teletype7/IRIS-v2/pcb/IRISV2_TOP/IRISV2_TOP.kicad_pcb

## KiCad design pcb/IRISV2_TOP/IRISV2_TOP.kicad_pcb (2026-07-20)

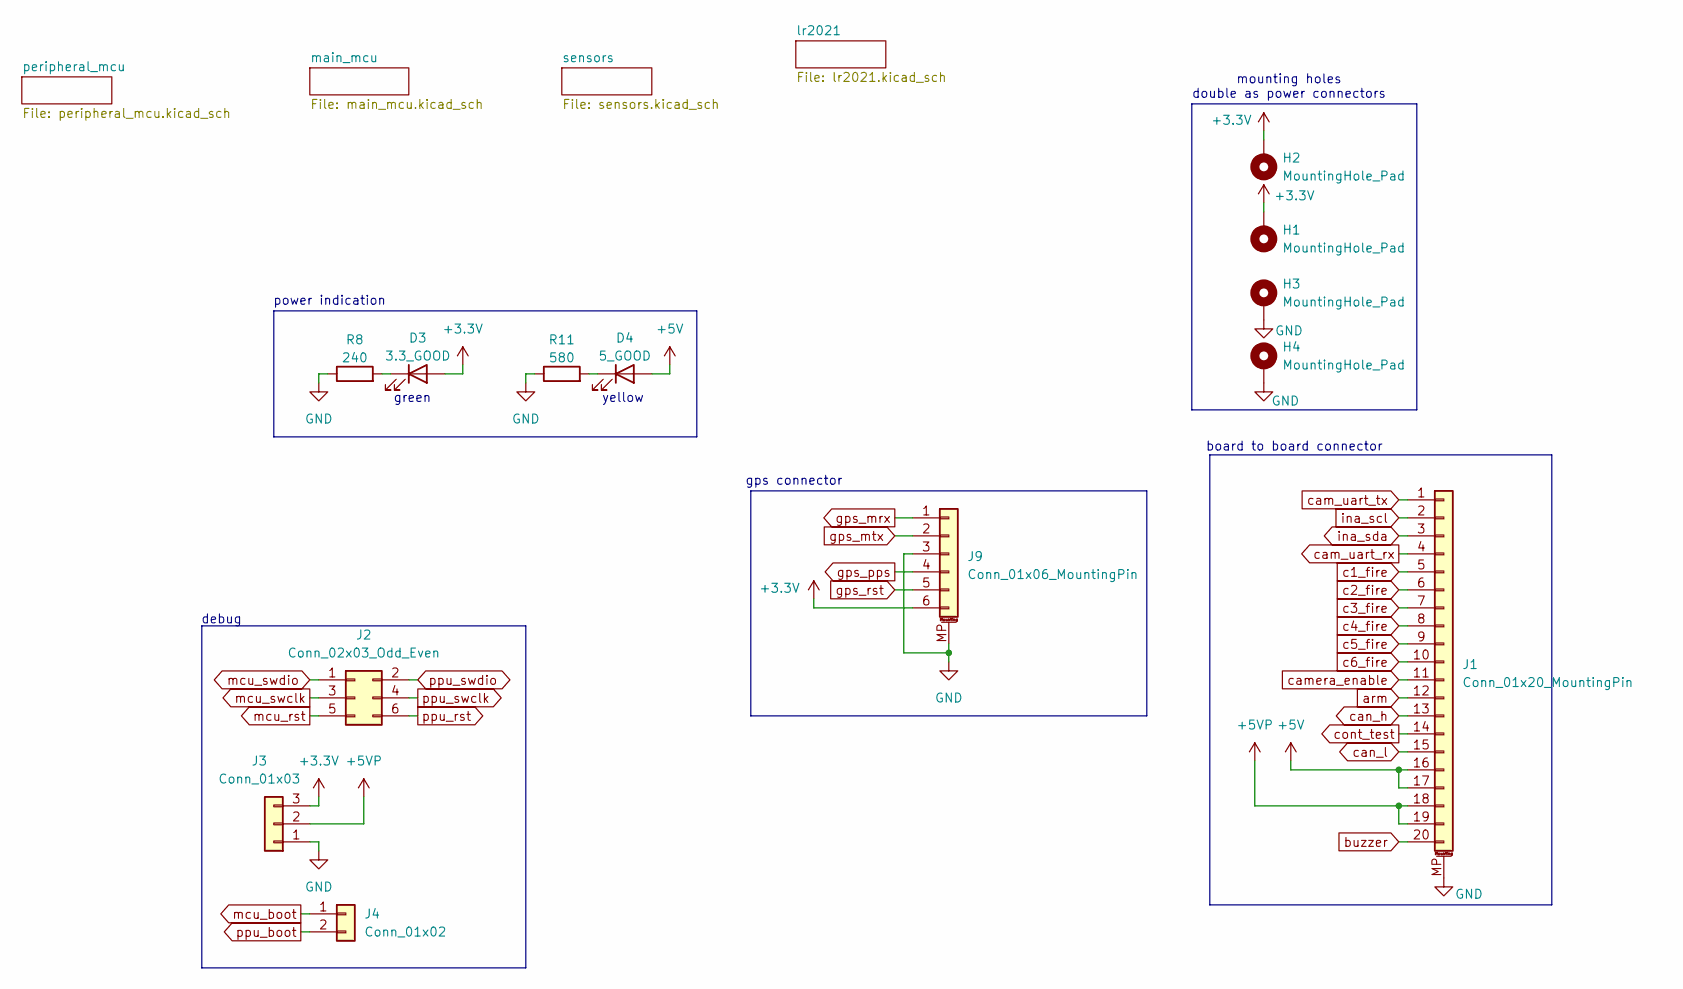
[picture p1: schematic IRISV2_TOP.kicad_sch]

Parts:
D3: 3.3_GOOD; LED_0805_2012Metric
D4: 5_GOOD; LED_0805_2012Metric
H1, H2, H3, H4: MountingHole_Pad; MountingHole_3.2mm_M3_ISO7380_Pad_TopBottom
J1: Conn_01x20_MountingPin; FFC3B07-20-T
J2: Conn_02x03_Odd_Even; PinHeader_2x03_P2.54mm_Vertical
J3: Conn_01x03; PinHeader_1x03_P2.54mm_Vertical
J4: Conn_01x02; PinHeader_1x02_P2.54mm_Vertical
J9: Conn_01x06_MountingPin; JST_PH_S6B-PH-SM4-TB_1x06-1MP_P2.00mm_Horizontal
R8: 240; R_0603_1608Metric
R11: 580; R_0603_1608Metric

Connections:
+3.3V: D3.2 (A), H1.1, H2.1, J3.3, J9.6; also elsewhere on the board
+5V: D4.2 (A), J1.16, J1.17; also elsewhere on the board
+5VP: J1.18, J1.19, J3.2
GND: H3.1, H4.1, J1.MP (MountPin), J3.1, J9.3, J9.MP (MountPin), R8.1, R11.1; also elsewhere on the board
unnamed: D3.1 (K), R8.2
unnamed: D4.1 (K), R11.2
arm: J1.12; also elsewhere on the board
buzzer: J1.20; also elsewhere on the board
c1_fire: J1.5; also elsewhere on the board
c2_fire: J1.6; also elsewhere on the board
c3_fire: J1.7; also elsewhere on the board
c4_fire: J1.8; also elsewhere on the board
c5_fire: J1.9; also elsewhere on the board
c6_fire: J1.10; also elsewhere on the board
cam_uart_rx: J1.4; also elsewhere on the board
cam_uart_tx: J1.1; also elsewhere on the board
camera_enable: J1.11; also elsewhere on the board
can_h: J1.13; also elsewhere on the board
can_l: J1.15; also elsewhere on the board
cont_test: J1.14; also elsewhere on the board
gps_mrx: J9.1; also elsewhere on the board
gps_mtx: J9.2; also elsewhere on the board
gps_pps: J9.4
gps_rst: J9.5
ina_scl: J1.2; also elsewhere on the board
ina_sda: J1.3; also elsewhere on the board
mcu_boot: J4.1; also elsewhere on the board
mcu_rst: J2.5; also elsewhere on the board
mcu_swclk: J2.3; also elsewhere on the board
mcu_swdio: J2.1; also elsewhere on the board
ppu_boot: J4.2; also elsewhere on the board
ppu_rst: J2.6; also elsewhere on the board
ppu_swclk: J2.4; also elsewhere on the board
ppu_swdio: J2.2; also elsewhere on the board

Notes on the sheet:
gps connector
debug
board to board connector
power indication
yellow
mounting holes double as power connectors
green

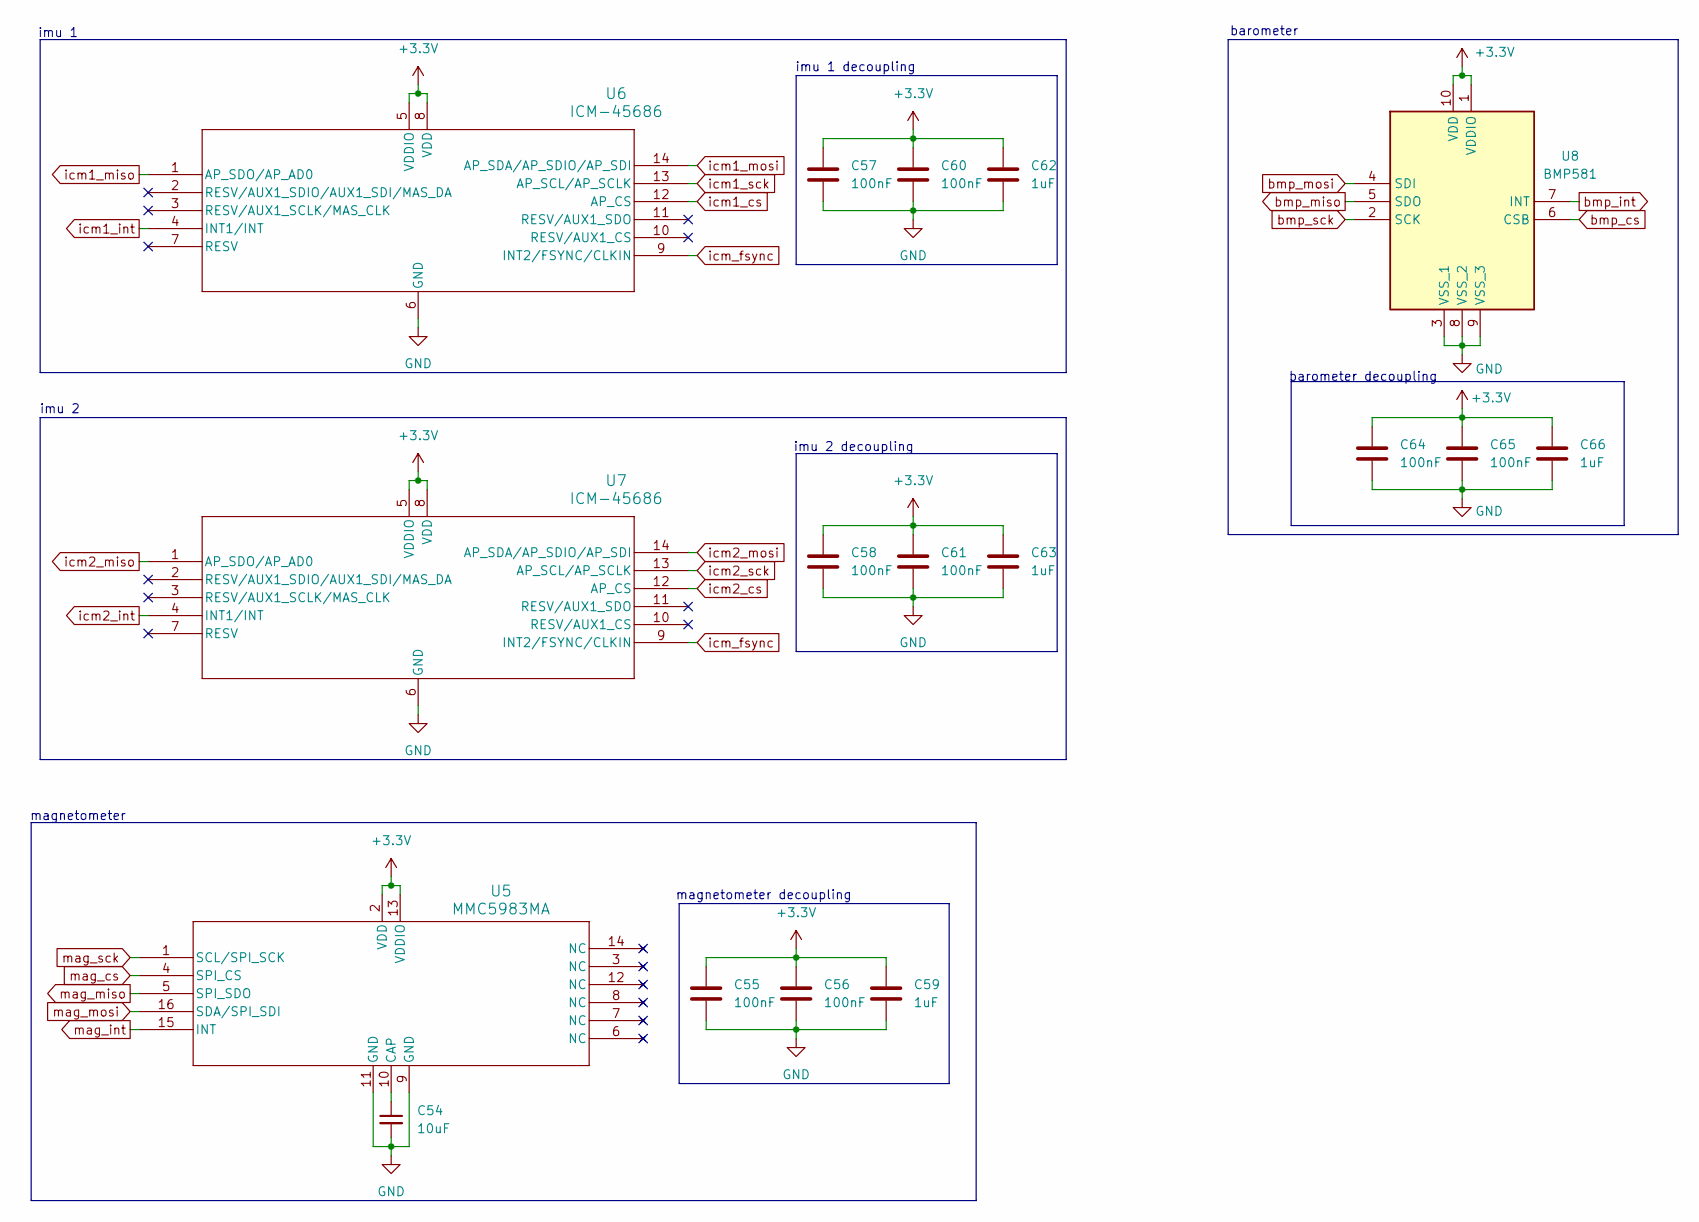
[picture p2: schematic sensors.kicad_sch]

Parts:
C54: 10uF; C_0603_1608Metric
C55, C56, C57, C58, C60, C61, C64, C65: 100nF; C_0402_1005Metric
C59, C62, C63, C66: 1uF; C_0603_1608Metric
U5: MMC5983MA; MMC5983MA_MEM
U6, U7: ICM-45686; U_2p5X3X0p81_LGA14L_TDK
U8: BMP581; Mouser Part Number 262-BMP581

Connections:
+3.3V: C55.1, C56.1, C57.1, C58.1, C59.1, C60.1, C61.1, C62.1, C63.1, C64.1, C65.1, C66.1, U5.2 (VDD), U5.13 (VDDIO), U6.5 (VDDIO), U6.8 (VDD), U7.5 (VDDIO), U7.8 (VDD), U8.1 (VDDIO), U8.10 (VDD); also elsewhere on the board
GND: C54.2, C55.2, C56.2, C57.2, C58.2, C59.2, C60.2, C61.2, C62.2, C63.2, C64.2, C65.2, C66.2, U5.9 (GND), U5.11 (GND), U6.6 (GND), U7.6 (GND), U8.3 (VSS_1), U8.8 (VSS_2), U8.9 (VSS_3); also elsewhere on the board
unnamed: C54.1, U5.10 (CAP)
bmp_cs: U8.6 (CSB); also elsewhere on the board
bmp_int: U8.7 (INT); also elsewhere on the board
bmp_miso: U8.5 (SDO); also elsewhere on the board
bmp_mosi: U8.4 (SDI); also elsewhere on the board
bmp_sck: U8.2 (SCK); also elsewhere on the board
icm1_cs: U6.12 (AP_CS); also elsewhere on the board
icm1_int: U6.4 (INT1/INT); also elsewhere on the board
icm1_miso: U6.1 (AP_SDO/AP_AD0); also elsewhere on the board
icm1_mosi: U6.14 (AP_SDA/AP_SDIO/AP_SDI); also elsewhere on the board
icm1_sck: U6.13 (AP_SCL/AP_SCLK); also elsewhere on the board
icm2_cs: U7.12 (AP_CS); also elsewhere on the board
icm2_int: U7.4 (INT1/INT); also elsewhere on the board
icm2_miso: U7.1 (AP_SDO/AP_AD0); also elsewhere on the board
icm2_mosi: U7.14 (AP_SDA/AP_SDIO/AP_SDI); also elsewhere on the board
icm2_sck: U7.13 (AP_SCL/AP_SCLK); also elsewhere on the board
icm_fsync: U6.9 (INT2/FSYNC/CLKIN), U7.9 (INT2/FSYNC/CLKIN); also elsewhere on the board
mag_cs: U5.4 (SPI_CS); also elsewhere on the board
mag_int: U5.15 (INT); also elsewhere on the board
mag_miso: U5.5 (SPI_SDO); also elsewhere on the board
mag_mosi: U5.16 (SDA/SPI_SDI); also elsewhere on the board
mag_sck: U5.1 (SCL/SPI_SCK); also elsewhere on the board

Notes on the sheet:
barometer decoupling
imu 1 decoupling
imu 2 decoupling
imu 1
imu 2
magnetometer decoupling
magnetometer
barometer

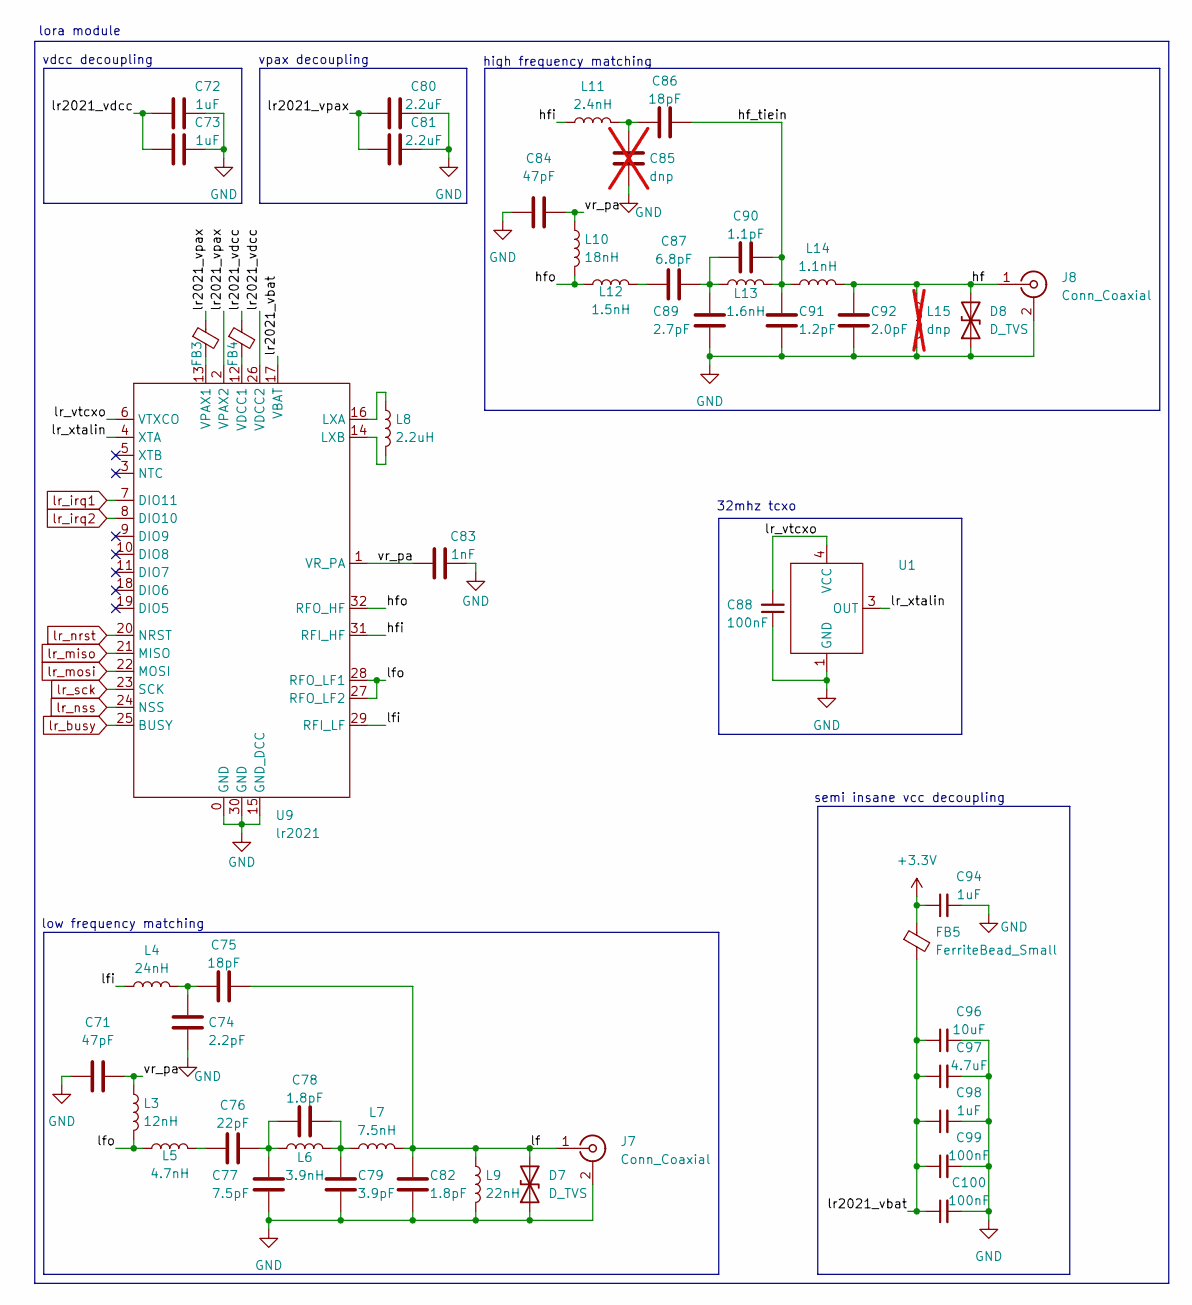
[picture p3: schematic lr2021.kicad_sch]

Parts:
C71, C84: 47pF; C_0201_0603Metric
C72, C73, C94, C98: 1uF; C_0603_1608Metric
C74: 2.2pF; C_0201_0603Metric
C75, C86: 18pF; C_0201_0603Metric
C76: 22pF; C_0201_0603Metric
C77: 7.5pF; C_0201_0603Metric
C78, C82: 1.8pF; C_0201_0603Metric
C79: 3.9pF; C_0201_0603Metric
C80, C81: 2.2uF; C_0603_1608Metric
C83: 1nF; C_0402_1005Metric
C85: dnp; C_0201_0603Metric; not fitted
C87: 6.8pF; C_0201_0603Metric
C88, C99, C100: 100nF; C_0402_1005Metric
C89: 2.7pF; C_0201_0603Metric
C90: 1.1pF; C_0201_0603Metric
C91: 1.2pF; C_0201_0603Metric
C92: 2.0pF; C_0201_0603Metric
C96: 10uF; C_0603_1608Metric
C97: 4.7uF; C_0603_1608Metric
D7, D8: D_TVS; D_0201_0603Metric
FB3, FB4, FB5: FerriteBead_Small; L_0402_1005Metric
J7, J8: Conn_Coaxial; U.FL_Hirose_U.FL-R-SMT-1_Vertical
L3: 12nH; L_0402_1005Metric
L4: 24nH; L_0201_0603Metric
L5: 4.7nH; L_0201_0603Metric
L6: 3.9nH; L_0201_0603Metric
L7: 7.5nH; L_0201_0603Metric
L8: 2.2uH; L_0603_1608Metric
L9: 22nH; L_0201_0603Metric
L10: 18nH; L_0201_0603Metric
L11: 2.4nH; L_0201_0603Metric
L12: 1.5nH; L_0201_0603Metric
L13: 1.6nH; L_0201_0603Metric
L14: 1.1nH; L_0201_0603Metric
L15: dnp; L_0201_0603Metric; not fitted
U1: ECS-TXO-20CSMV4
U9: lr2021; LR2021_thermalvias

Connections:
+3.3V: C94.1, FB5.1; also elsewhere on the board
/lr2021/hf: C92.1, D8.2 (A2), J8.1 (In), L14.2, L15.1
/lr2021/hf_tiein: C86.2, C90.2, C91.1, L13.2, L14.1
/lr2021/hfi: L11.1, U9.31 (RFI_HF)
/lr2021/hfo: L10.2, L12.1, U9.32 (RFO_HF)
/lr2021/lf: C75.2, C82.1, D7.2 (A2), J7.1 (In), L7.2, L9.1
/lr2021/lfi: L4.1, U9.29 (RFI_LF)
/lr2021/lfo: L3.2, L5.1, U9.27 (RFO_LF2), U9.28 (RFO_LF1)
/lr2021/lr2021_vbat: C96.1, C97.1, C98.1, C99.1, C100.1, FB5.2, U9.17 (VBAT)
/lr2021/lr2021_vdcc: C72.1, C73.1, FB4.1, U9.26 (VDCC2)
/lr2021/lr2021_vpax: C80.1, C81.1, FB3.1, U9.2 (VPAX2)
/lr2021/lr_vtcxo: C88.2, U1.4 (VCC), U9.6 (VTXCO)
/lr2021/lr_xtalin: U1.3 (OUT), U9.4 (XTA)
/lr2021/vr_pa: C71.2, C83.1, C84.2, L3.1, L10.1, U9.1 (VR_PA)
GND: C71.1, C72.2, C73.2, C74.2, C77.2, C79.2, C80.2, C81.2, C82.2, C83.2, C84.1, C85.2, C88.1, C89.2, C91.2, C92.2, C94.2, C96.2, C97.2, C98.2, C99.2, C100.2, D7.1 (A1), D8.1 (A1), J7.2 (Ext), J8.2 (Ext), L9.2, L15.2, U1.1 (GND), U9.0 (GND), U9.15 (GND_DCC), U9.30 (GND); also elsewhere on the board
unnamed: C74.1, C75.1, L4.2
unnamed: C76.1, L5.2
unnamed: C76.2, C77.1, C78.1, L6.1
unnamed: C78.2, C79.1, L6.2, L7.1
unnamed: C85.1, C86.1, L11.2
unnamed: C87.1, L12.2
unnamed: C87.2, C89.1, C90.1, L13.1
unnamed: L8.1, U9.16 (LXA)
unnamed: L8.2, U9.14 (LXB)
unnamed: FB4.2, U9.12 (VDCC1)
unnamed: FB3.2, U9.13 (VPAX1)
lr_busy: U9.25 (BUSY); also elsewhere on the board
lr_irq1: U9.7 (DIO11); also elsewhere on the board
lr_irq2: U9.8 (DIO10); also elsewhere on the board
lr_miso: U9.21 (MISO); also elsewhere on the board
lr_mosi: U9.22 (MOSI); also elsewhere on the board
lr_nrst: U9.20 (NRST); also elsewhere on the board
lr_nss: U9.24 (NSS); also elsewhere on the board
lr_sck: U9.23 (SCK); also elsewhere on the board

Notes on the sheet:
high frequency matching
lora module
low frequency matching
vdcc decoupling
vpax decoupling
semi insane vcc decoupling
32mhz tcxo

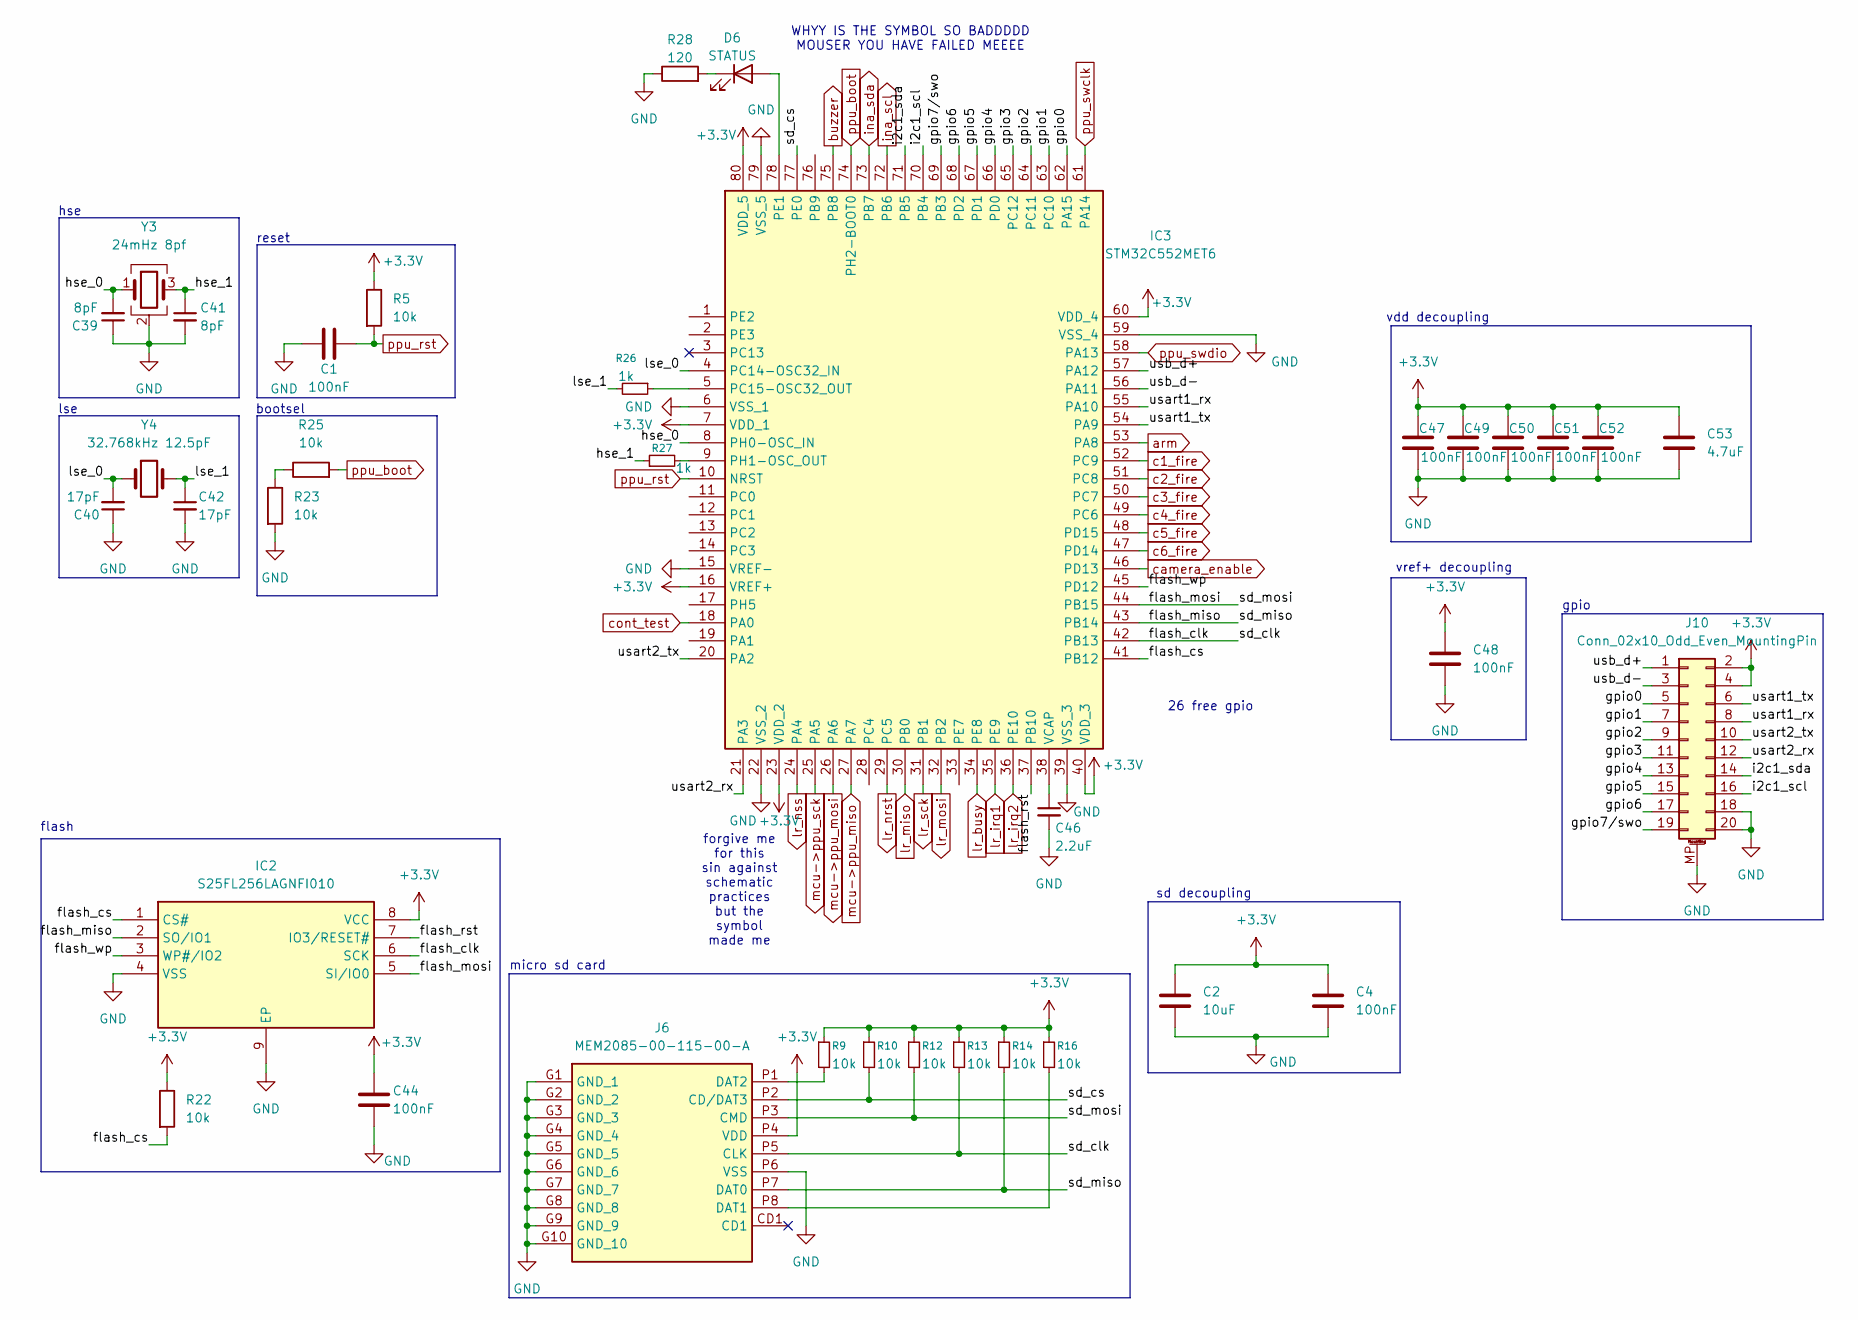
[picture p4: schematic peripheral_mcu.kicad_sch]

Parts:
C1, C4, C44, C47, C48, C49, C50, C51, C52: 100nF; C_0402_1005Metric
C2: 10uF; C_0603_1608Metric
C39, C41: 8pF; C_0402_1005Metric
C40, C42: 17pF; C_0402_1005Metric
C46: 2.2uF; C_0603_1608Metric
C53: 4.7uF; C_0603_1608Metric
D6: STATUS; LED_0805_2012Metric
IC2: S25FL256LAGNFI010; SON127P800X600X80-9N-D; Mouser Part Number 727-S25FL256LAGNFI00
IC3: STM32C552MET6; QFP50P1400X1400X160-80N; Manufacturer_Part_Number STM32C552MET6
J6: MEM2085-00-115-00-A; MEM20850011500A; Mouser Part Number 640-MEM20850011500A
J10: Conn_02x10_Odd_Even_MountingPin; AMPHENOL_10164228-0201A1RLF
R5, R9, R10, R12, R13, R14, R16, R22, R23, R25: 10k; R_0402_1005Metric
R26, R27: 1k; R_0402_1005Metric
R28: 120; R_0603_1608Metric
Y3: 24mHz 8pf; Crystal_SMD_3225-4Pin_3.2x2.5mm
Y4: 32.768kHz 12.5pF; Crystal_SMD_3215-2Pin_3.2x1.5mm

Connections:
+3.3V: C2.1, C4.1, C44.1, C47.1, C48.1, C49.1, C50.1, C51.1, C52.1, C53.1, IC2.8 (VCC), IC3.7 (VDD_1), IC3.16 (VREF+), IC3.23 (VDD_2), IC3.40 (VDD_3), IC3.60 (VDD_4), IC3.80 (VDD_5), J6.P4 (VDD), J10.2, J10.4, R5.1, R9.1, R10.1, R12.1, R13.1, R14.1, R16.1, R22.1; also elsewhere on the board
/peripheral_mcu/flash_clk: IC2.6 (SCK), IC3.42 (PB13), J6.P5 (CLK), R13.2
/peripheral_mcu/flash_cs: IC2.1 (CS#), IC3.41 (PB12), R22.2
/peripheral_mcu/flash_miso: IC2.2 (SO/IO1), IC3.43 (PB14), J6.P7 (DAT0), R14.2
/peripheral_mcu/flash_mosi: IC2.5 (SI/IO0), IC3.44 (PB15), J6.P3 (CMD), R12.2
/peripheral_mcu/flash_rst: IC2.7 (IO3/RESET#), IC3.37 (PB10)
/peripheral_mcu/flash_wp: IC2.3 (WP#/IO2), IC3.45 (PD12)
/peripheral_mcu/gpio0: IC3.62 (PA15), J10.5
/peripheral_mcu/gpio1: IC3.63 (PC10), J10.7
/peripheral_mcu/gpio2: IC3.64 (PC11), J10.9
/peripheral_mcu/gpio3: IC3.65 (PC12), J10.11
/peripheral_mcu/gpio4: IC3.66 (PD0), J10.13
/peripheral_mcu/gpio5: IC3.67 (PD1), J10.15
/peripheral_mcu/gpio6: IC3.68 (PD2), J10.17
/peripheral_mcu/gpio7/swo: IC3.69 (PB3), J10.19
/peripheral_mcu/hse_0: C39.2, IC3.8 (PH0-OSC_IN), Y3.1
/peripheral_mcu/hse_1: C41.1, R27.1, Y3.3
/peripheral_mcu/i2c1_scl: IC3.70 (PB4), J10.16
/peripheral_mcu/i2c1_sda: IC3.71 (PB5), J10.14
/peripheral_mcu/lse_0: C40.2, IC3.4 (PC14-OSC32_IN), Y4.1
/peripheral_mcu/lse_1: C42.1, R26.2, Y4.2
/peripheral_mcu/sd_cs: IC3.77 (PE0), J6.P2 (CD/DAT3), R10.2
/peripheral_mcu/usart1_rx: IC3.55 (PA10), J10.8
/peripheral_mcu/usart1_tx: IC3.54 (PA9), J10.6
/peripheral_mcu/usart2_rx: IC3.21 (PA3), J10.12
/peripheral_mcu/usart2_tx: IC3.20 (PA2), J10.10
/peripheral_mcu/usb_d+: IC3.57 (PA12), J10.1
/peripheral_mcu/usb_d-: IC3.56 (PA11), J10.3
GND: C1.2, C2.2, C4.2, C39.1, C40.1, C41.2, C42.2, C44.2, C46.2, C47.2, C48.2, C49.2, C50.2, C51.2, C52.2, C53.2, IC2.4 (VSS), IC2.9 (EP), IC3.6 (VSS_1), IC3.15 (VREF-), IC3.22 (VSS_2), IC3.39 (VSS_3), IC3.59 (VSS_4), IC3.79 (VSS_5), J6.G1 (GND_1), J6.G2 (GND_2), J6.G3 (GND_3), J6.G4 (GND_4), J6.G5 (GND_5), J6.G6 (GND_6), J6.G7 (GND_7), J6.G8 (GND_8), J6.G9 (GND_9), J6.G10 (GND_10), J6.P6 (VSS), J10.18, J10.20, J10.MP (MountPin), R23.2, R28.1, Y3.2 (G), Y3.4 (G); also elsewhere on the board
unnamed: D6.2 (A), IC3.78 (PE1)
unnamed: D6.1 (K), R28.2
unnamed: IC3.5 (PC15-OSC32_OUT), R26.1
unnamed: IC3.9 (PH1-OSC_OUT), R27.2
unnamed: C46.1, IC3.38 (VCAP)
unnamed: J6.P8 (DAT1), R16.2
unnamed: J6.P1 (DAT2), R9.2
unnamed: R23.1, R25.1
arm: IC3.53 (PA8); also elsewhere on the board
buzzer: IC3.75 (PB8); also elsewhere on the board
c1_fire: IC3.52 (PC9); also elsewhere on the board
c2_fire: IC3.51 (PC8); also elsewhere on the board
c3_fire: IC3.50 (PC7); also elsewhere on the board
c4_fire: IC3.49 (PC6); also elsewhere on the board
c5_fire: IC3.48 (PD15); also elsewhere on the board
c6_fire: IC3.47 (PD14); also elsewhere on the board
camera_enable: IC3.46 (PD13); also elsewhere on the board
cont_test: IC3.18 (PA0); also elsewhere on the board
ina_scl: IC3.72 (PB6); also elsewhere on the board
ina_sda: IC3.73 (PB7); also elsewhere on the board
lr_busy: IC3.34 (PE8); also elsewhere on the board
lr_irq1: IC3.35 (PE9); also elsewhere on the board
lr_irq2: IC3.36 (PE10); also elsewhere on the board
lr_miso: IC3.30 (PB0); also elsewhere on the board
lr_mosi: IC3.32 (PB2); also elsewhere on the board
lr_nrst: IC3.29 (PC5); also elsewhere on the board
lr_nss: IC3.24 (PA4); also elsewhere on the board
lr_sck: IC3.31 (PB1); also elsewhere on the board
mcu->ppu_miso: IC3.27 (PA7); also elsewhere on the board
mcu->ppu_mosi: IC3.26 (PA6); also elsewhere on the board
mcu->ppu_sck: IC3.25 (PA5); also elsewhere on the board
ppu_boot: IC3.74 (PH2-BOOT0), R25.2; also elsewhere on the board
ppu_rst: C1.1, IC3.10 (NRST), R5.2; also elsewhere on the board
ppu_swclk: IC3.61 (PA14); also elsewhere on the board
ppu_swdio: IC3.58 (PA13); also elsewhere on the board

Notes on the sheet:
forgive me for this sin against schematic practices but the symbol made me
micro sd card
vref+ decoupling
gpio
lse
flash
sd decoupling
26 free gpio
vdd decoupling
reset
hse
bootsel
WHYY IS THE SYMBOL SO BADDDDD MOUSER YOU HAVE FAILED MEEEE

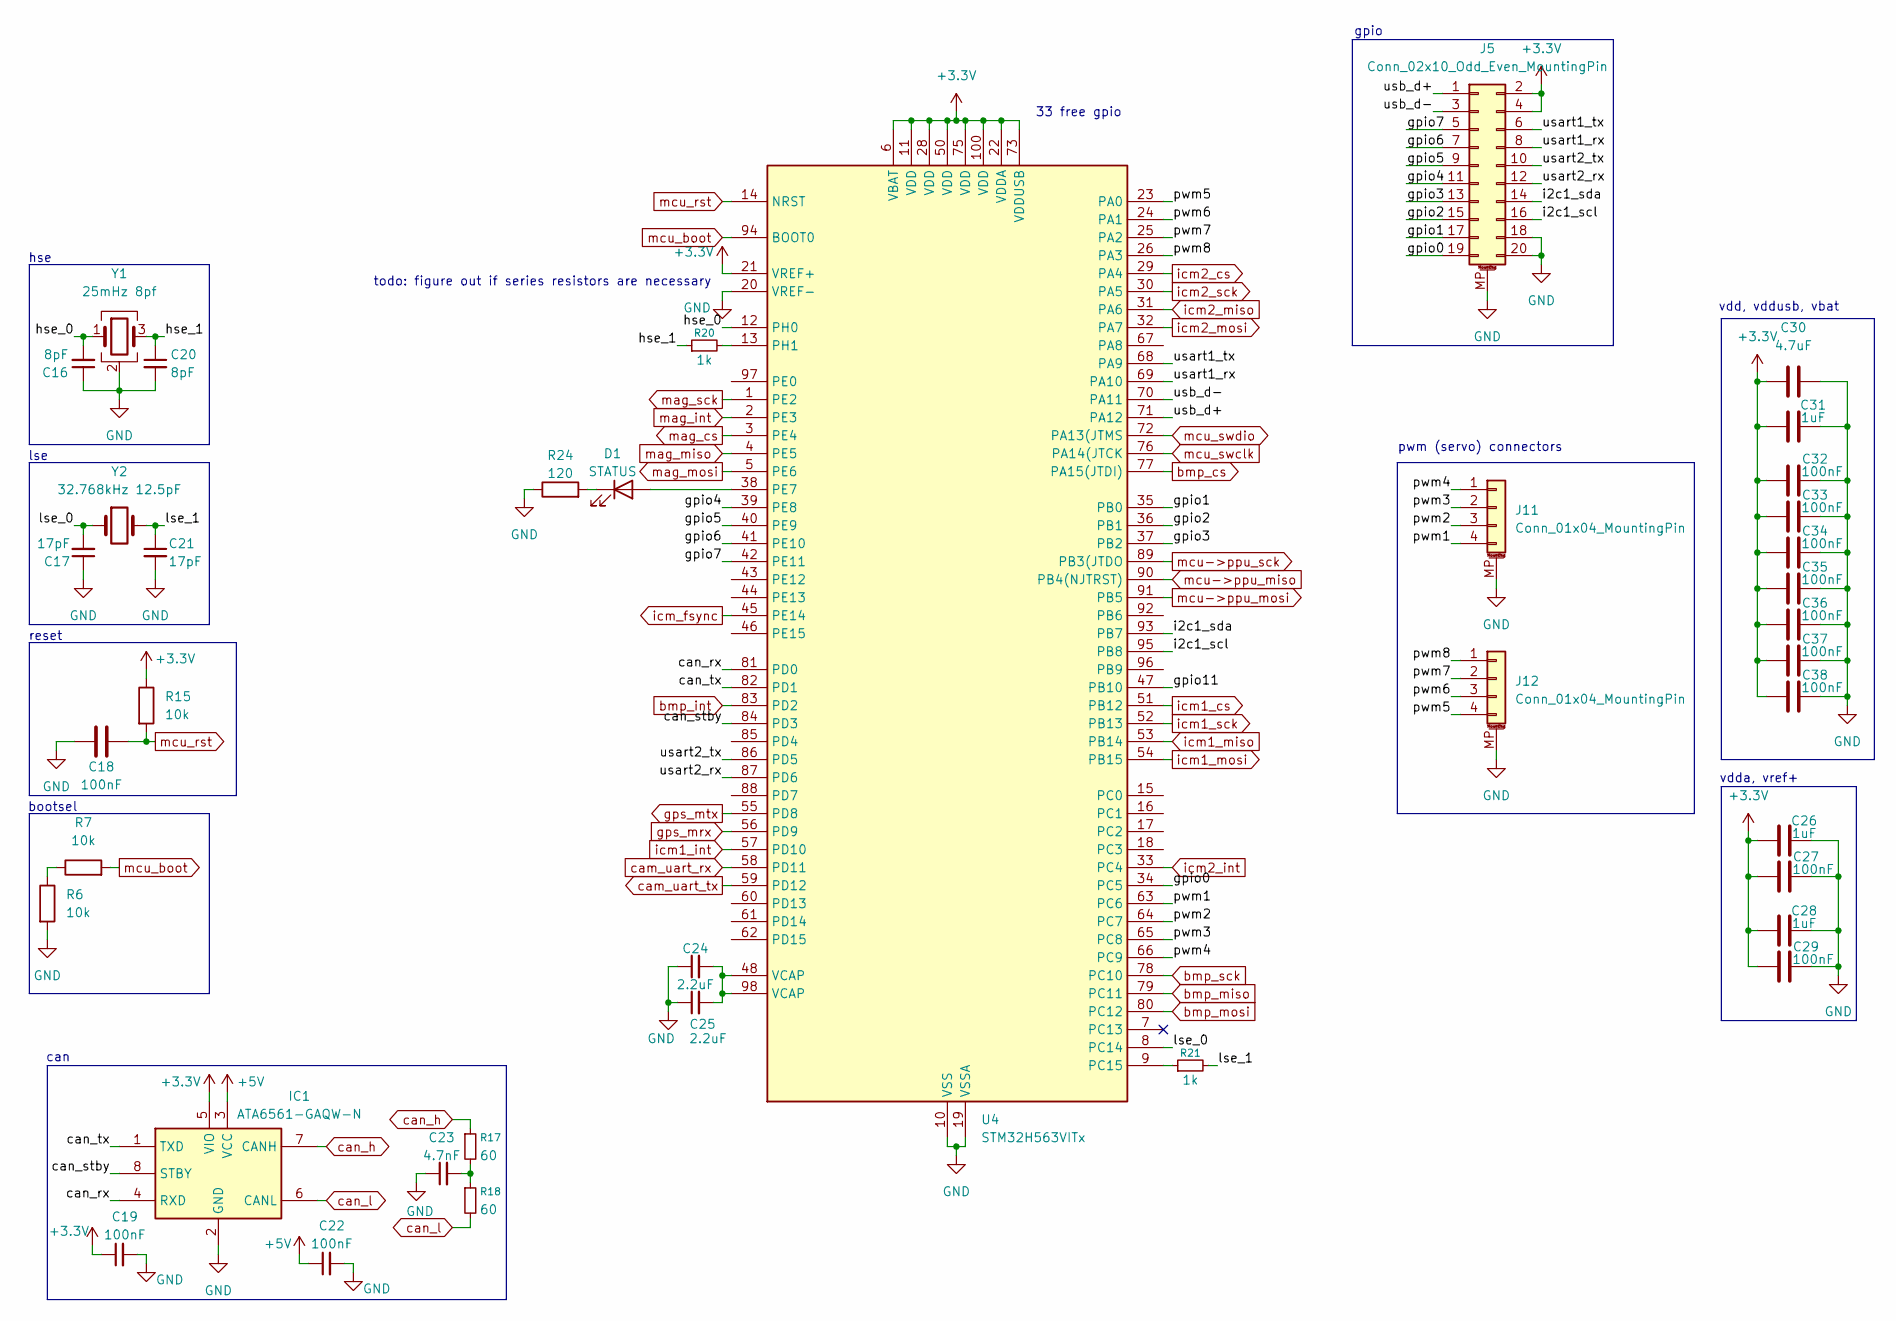
[picture p5: schematic main_mcu.kicad_sch]

Parts:
C16, C20: 8pF; C_0402_1005Metric
C17, C21: 17pF; C_0402_1005Metric
C18, C19, C22, C27, C29, C32, C33, C34, C35, C36, C37, C38: 100nF; C_0402_1005Metric
C23: 4.7nF; C_0402_1005Metric
C24, C25: 2.2uF; C_0603_1608Metric
C26, C28, C31: 1uF; C_0603_1608Metric
C30: 4.7uF; C_0603_1608Metric
D1: STATUS; LED_0805_2012Metric
IC1: ATA6561-GAQW-N; SOIC127P600X175-8N; Mouser Part Number 579-ATA6561-GAQW-N
J5: Conn_02x10_Odd_Even_MountingPin; AMPHENOL_10164228-0201A1RLF
J11, J12: Conn_01x04_MountingPin; JST_PH_S4B-PH-SM4-TB_1x04-1MP_P2.00mm_Horizontal
R6, R7, R15: 10k; R_0402_1005Metric
R17, R18: 60; R_0402_1005Metric
R20, R21: 1k; R_0402_1005Metric
R24: 120; R_0603_1608Metric
U4: STM32H563VITx; LQFP-100_14x14mm_P0.5mm
Y1: 25mHz 8pf; Crystal_SMD_3225-4Pin_3.2x2.5mm
Y2: 32.768kHz 12.5pF; Crystal_SMD_3215-2Pin_3.2x1.5mm

Connections:
+3.3V: C19.1, C26.1, C27.1, C28.1, C29.1, C30.1, C31.1, C32.1, C33.1, C34.1, C35.1, C36.1, C37.1, C38.1, IC1.5 (VIO), J5.2, J5.4, R15.1, U4.6 (VBAT), U4.11 (VDD), U4.21 (VREF+), U4.22 (VDDA), U4.28 (VDD), U4.50 (VDD), U4.73 (VDDUSB), U4.75 (VDD), U4.100 (VDD); also elsewhere on the board
+5V: C22.1, IC1.3 (VCC); also elsewhere on the board
/main_mcu/can_rx: IC1.4 (RXD), U4.81 (PD0)
/main_mcu/can_stby: IC1.8 (STBY), U4.84 (PD3)
/main_mcu/can_tx: IC1.1 (TXD), U4.82 (PD1)
/main_mcu/gpio0: J5.19, U4.34 (PC5)
/main_mcu/gpio1: J5.17, U4.35 (PB0)
/main_mcu/gpio2: J5.15, U4.36 (PB1)
/main_mcu/gpio3: J5.13, U4.37 (PB2)
/main_mcu/gpio4: J5.11, U4.39 (PE8)
/main_mcu/gpio5: J5.9, U4.40 (PE9)
/main_mcu/gpio6: J5.7, U4.41 (PE10)
/main_mcu/gpio7: J5.5, U4.42 (PE11)
/main_mcu/gpio11: U4.47 (PB10)
/main_mcu/hse_0: C16.2, U4.12 (PH0), Y1.1
/main_mcu/hse_1: C20.1, R20.1, Y1.3
/main_mcu/i2c1_scl: J5.16, U4.95 (PB8)
/main_mcu/i2c1_sda: J5.14, U4.93 (PB7)
/main_mcu/lse_0: C17.2, U4.8 (PC14), Y2.1
/main_mcu/lse_1: C21.1, R21.2, Y2.2
/main_mcu/pwm1: J11.4, U4.63 (PC6)
/main_mcu/pwm2: J11.3, U4.64 (PC7)
/main_mcu/pwm3: J11.2, U4.65 (PC8)
/main_mcu/pwm4: J11.1, U4.66 (PC9)
/main_mcu/pwm5: J12.4, U4.23 (PA0)
/main_mcu/pwm6: J12.3, U4.24 (PA1)
/main_mcu/pwm7: J12.2, U4.25 (PA2)
/main_mcu/pwm8: J12.1, U4.26 (PA3)
/main_mcu/usart1_rx: J5.8, U4.69 (PA10)
/main_mcu/usart1_tx: J5.6, U4.68 (PA9)
/main_mcu/usart2_rx: J5.12, U4.87 (PD6)
/main_mcu/usart2_tx: J5.10, U4.86 (PD5)
/main_mcu/usb_d+: J5.1, U4.71 (PA12)
/main_mcu/usb_d-: J5.3, U4.70 (PA11)
GND: C16.1, C17.1, C18.2, C19.2, C20.2, C21.2, C22.2, C23.1, C24.1, C25.1, C26.2, C27.2, C28.2, C29.2, C30.2, C31.2, C32.2, C33.2, C34.2, C35.2, C36.2, C37.2, C38.2, IC1.2 (GND), J5.18, J5.20, J5.MP (MountPin), J11.MP (MountPin), J12.MP (MountPin), R6.2, R24.1, U4.10 (VSS), U4.19 (VSSA), U4.20 (VREF-), U4.27 (VSS), U4.49 (VSS), U4.74 (VSS), U4.99 (VSS), Y1.2 (G), Y1.4 (G); also elsewhere on the board
unnamed: C23.2, R17.2, R18.1
unnamed: C24.2, C25.2, U4.48 (VCAP), U4.98 (VCAP)
unnamed: D1.2 (A), U4.38 (PE7)
unnamed: D1.1 (K), R24.2
unnamed: R6.1, R7.1
unnamed: R21.1, U4.9 (PC15)
unnamed: R20.2, U4.13 (PH1)
bmp_cs: U4.77 (PA15(JTDI)); also elsewhere on the board
bmp_int: U4.83 (PD2); also elsewhere on the board
bmp_miso: U4.79 (PC11); also elsewhere on the board
bmp_mosi: U4.80 (PC12); also elsewhere on the board
bmp_sck: U4.78 (PC10); also elsewhere on the board
cam_uart_rx: U4.58 (PD11); also elsewhere on the board
cam_uart_tx: U4.59 (PD12); also elsewhere on the board
can_h: IC1.7 (CANH), R17.1; also elsewhere on the board
can_l: IC1.6 (CANL), R18.2; also elsewhere on the board
gps_mrx: U4.56 (PD9); also elsewhere on the board
gps_mtx: U4.55 (PD8); also elsewhere on the board
icm1_cs: U4.51 (PB12); also elsewhere on the board
icm1_int: U4.57 (PD10); also elsewhere on the board
icm1_miso: U4.53 (PB14); also elsewhere on the board
icm1_mosi: U4.54 (PB15); also elsewhere on the board
icm1_sck: U4.52 (PB13); also elsewhere on the board
icm2_cs: U4.29 (PA4); also elsewhere on the board
icm2_int: U4.33 (PC4); also elsewhere on the board
icm2_miso: U4.31 (PA6); also elsewhere on the board
icm2_mosi: U4.32 (PA7); also elsewhere on the board
icm2_sck: U4.30 (PA5); also elsewhere on the board
icm_fsync: U4.45 (PE14); also elsewhere on the board
mag_cs: U4.3 (PE4); also elsewhere on the board
mag_int: U4.2 (PE3); also elsewhere on the board
mag_miso: U4.4 (PE5); also elsewhere on the board
mag_mosi: U4.5 (PE6); also elsewhere on the board
mag_sck: U4.1 (PE2); also elsewhere on the board
mcu->ppu_miso: U4.90 (PB4(NJTRST)); also elsewhere on the board
mcu->ppu_mosi: U4.91 (PB5); also elsewhere on the board
mcu->ppu_sck: U4.89 (PB3(JTDO); also elsewhere on the board
mcu_boot: R7.2, U4.94 (BOOT0); also elsewhere on the board
mcu_rst: C18.1, R15.2, U4.14 (NRST); also elsewhere on the board
mcu_swclk: U4.76 (PA14(JTCK); also elsewhere on the board
mcu_swdio: U4.72 (PA13(JTMS); also elsewhere on the board

Notes on the sheet:
vdd, vddusb, vbat
lse
todo: figure out if series resistors are necessary
can
reset
bootsel
pwm (servo) connectors
vdda, vref+
33 free gpio
hse
gpio

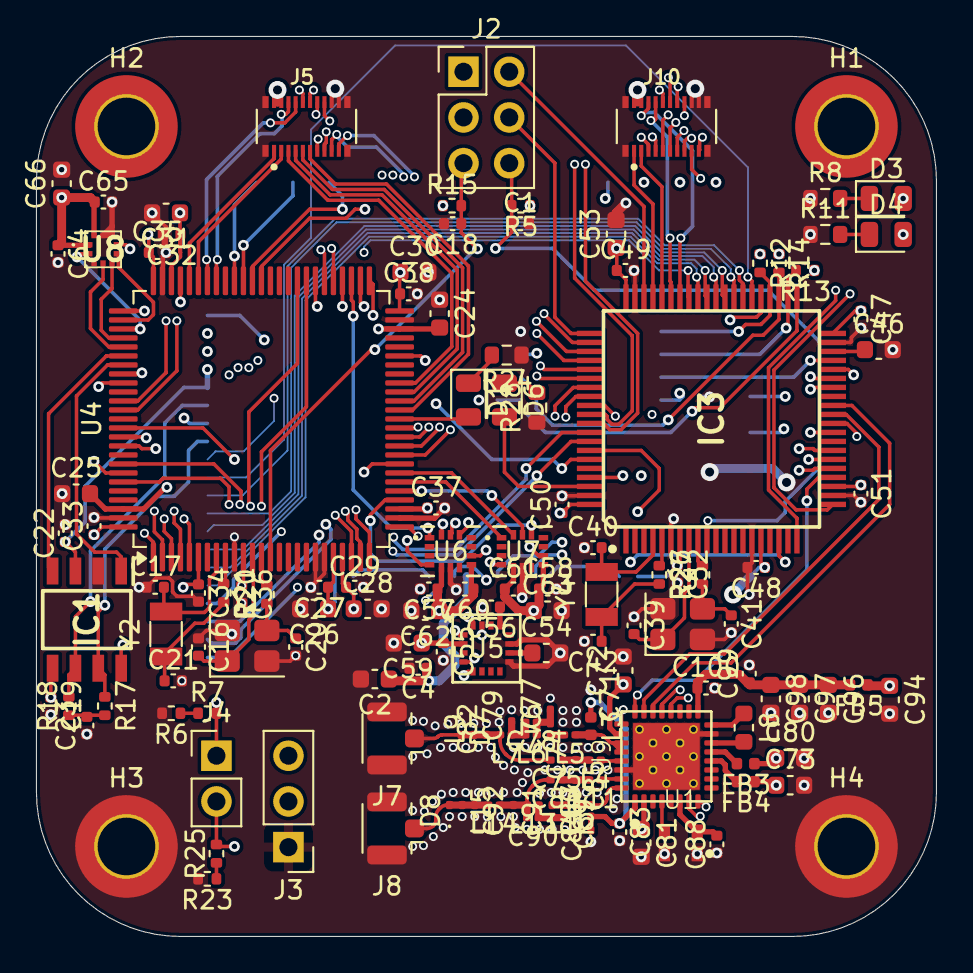
[picture p6: board IRISV2_TOP.kicad_pcb from above]

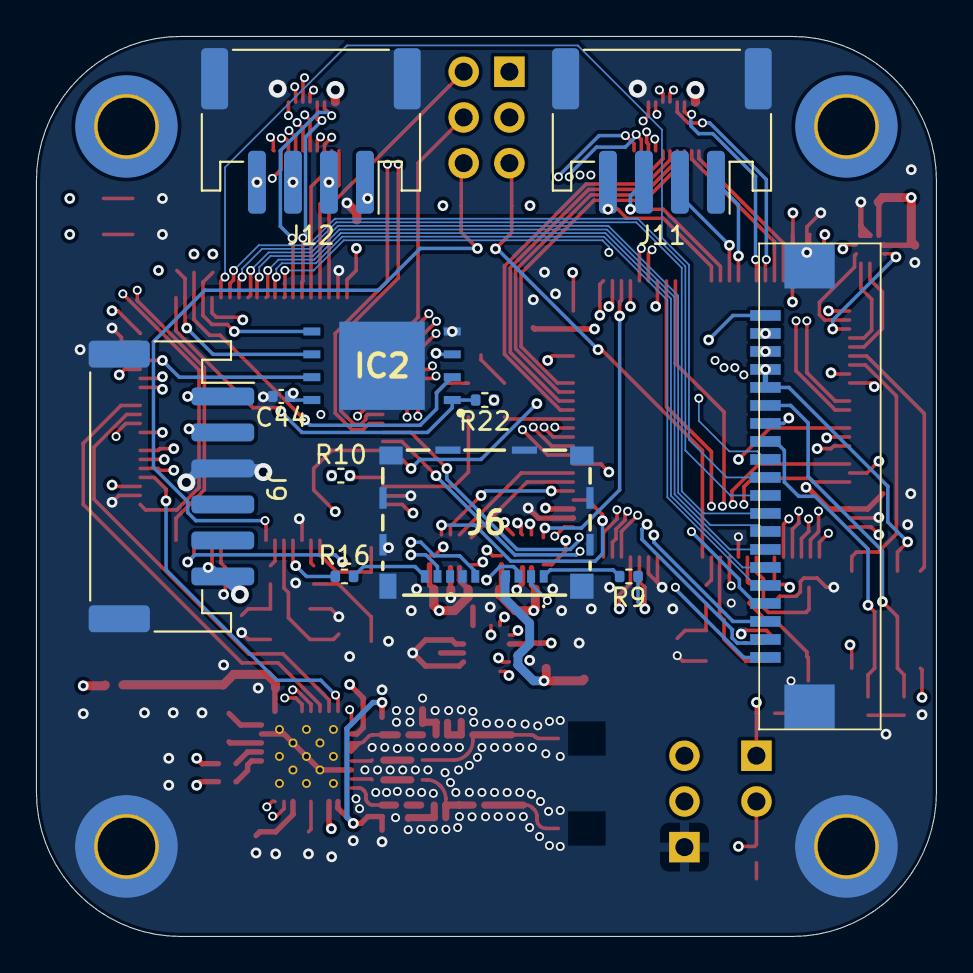
[picture p7: board IRISV2_TOP.kicad_pcb from below]

Board: 6 copper layers, 50.0 x 50.0 mm, 155 parts (11 on the bottom side), 162 nets.
