teletype7/IRIS-v2/pcb/IRISV2_BOTTOM/IRISV2_BOTTOM.kicad_pcb

## KiCad design pcb/IRISV2_BOTTOM/IRISV2_BOTTOM.kicad_pcb (2026-07-20)

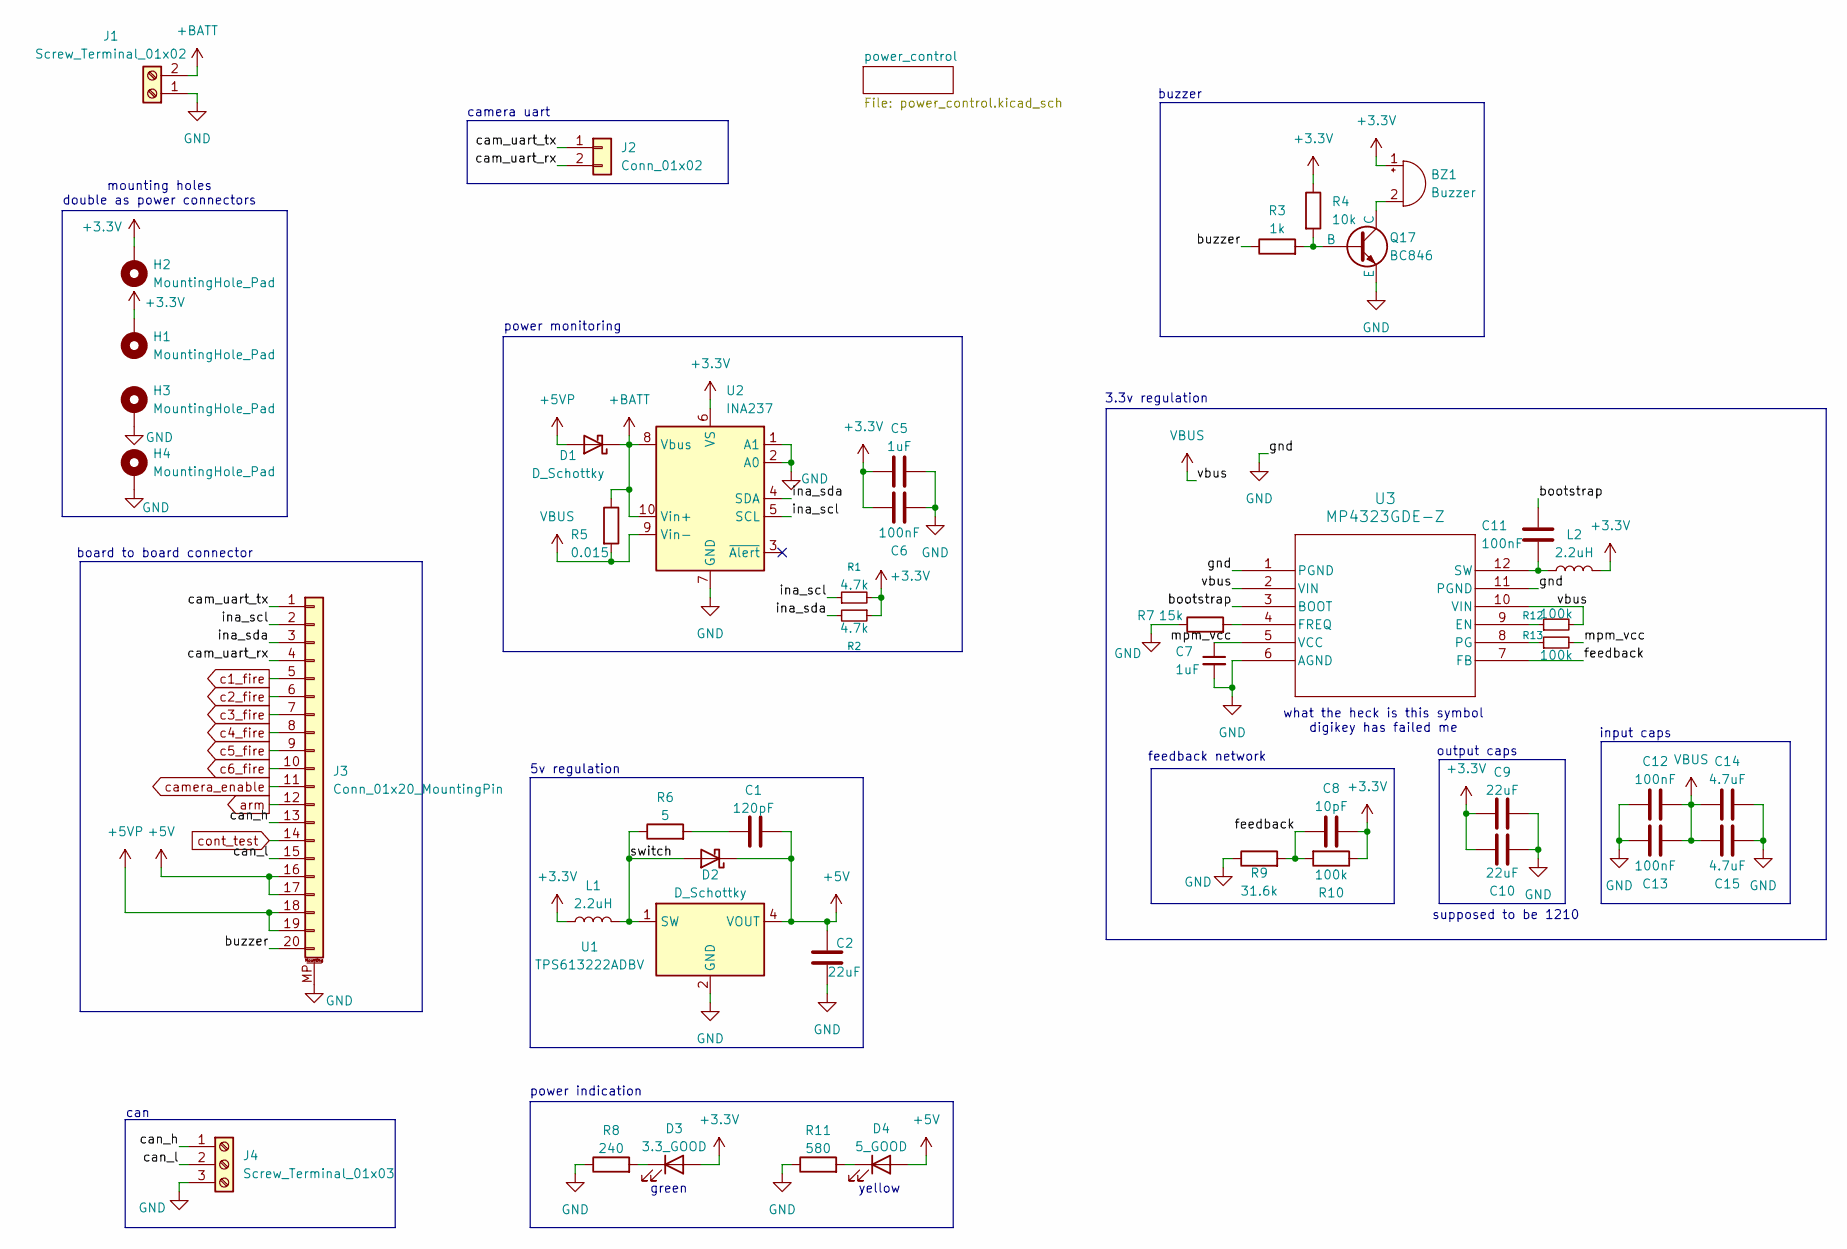
[picture p8: schematic IRISV2_BOTTOM.kicad_sch]

Parts:
BZ1: Buzzer; CMT850403SMTTR
C1: 120pF; C_0603_1608Metric
C2: 22uF; C_1206_3216Metric
C5, C7: 1uF; C_0603_1608Metric
C6: 100nF; C_0402_1005Metric
C8: 10pF; C_0402_1005Metric
C9, C10: 22uF; C_1210_3225Metric
C11, C12, C13: 100nF; C_0603_1608Metric
C14, C15: 4.7uF; C_1210_3225Metric
D1, D2: D_Schottky; DIOM5027X240N
D3: 3.3_GOOD; LED_0805_2012Metric
D4: 5_GOOD; LED_0805_2012Metric
H1, H2, H3, H4: MountingHole_Pad; MountingHole_3.2mm_M3_ISO7380_Pad_TopBottom
J1: Screw_Terminal_01x02; kf350-2p
J2: Conn_01x02; PinHeader_1x02_P2.54mm_Vertical
J3: Conn_01x20_MountingPin; FFC3B07-20-T
J4: Screw_Terminal_01x03; OSTTE030104
L1: 2.2uH; L_1008_2520Metric
L2: 2.2uH; SRP5020TA2R2M
Q17: BC846; SOT-23-3
R1, R2: 4.7k; R_0402_1005Metric
R3: 1k; R_0402_1005Metric
R4: 10k; R_0402_1005Metric
R5: 0.015; R_2512_6332Metric
R6: 5; R_0603_1608Metric
R7: 15k; R_0402_1005Metric
R8: 240; R_0603_1608Metric
R9: 31.6k; R_0402_1005Metric
R10, R12, R13: 100k; R_0402_1005Metric
R11: 580; R_0603_1608Metric
U1: TPS613222ADBV; SOT-23-5
U2: INA237; VSSOP-10_3x3mm_P0.5mm
U3: MP4323GDE-Z; QFN-12_MP4323_MNP

Connections:
+3.3V: BZ1.1 (+), C5.1, C6.2, C8.2, C9.1, C10.2, D3.2 (A), H1.1, H2.1, L1.1, L2.2, R1.2, R2.1, R4.1, R10.1, U2.6 (VS); also elsewhere on the board
+5V: C1.2, C2.1, D2.1 (K), D4.2 (A), J3.16, J3.17, U1.4 (VOUT)
+5VP: D1.2 (A), J3.18, J3.19
+BATT: D1.1 (K), J1.2, R5.1, U2.8 (Vbus), U2.10 (Vin+); also elsewhere on the board
/bootstrap: C11.1, U3.3 (BOOT)
/buzzer: J3.20, R3.1
/cam_uart_rx: J2.2, J3.4
/cam_uart_tx: J2.1, J3.1
/can_h: J3.13, J4.1
/can_l: J3.15, J4.2
/feedback: C8.1, R9.2, R10.2, U3.7 (FB)
/ina_scl: J3.2, R1.1, U2.5 (SCL)
/ina_sda: J3.3, R2.2, U2.4 (SDA)
/mpm_vcc: C7.1, R13.2, U3.5 (VCC)
/switch: D2.2 (A), L1.2, R6.1, U1.1 (SW)
GND: C2.2, C5.2, C6.1, C7.2, C9.2, C10.1, C12.1, C13.2, C14.2, C15.1, H3.1, H4.1, J1.1, J3.MP (MountPin), J4.3, Q17.3 (E), R7.1, R8.1, R9.1, R11.1, U1.2 (GND), U2.1 (A1), U2.2 (A0), U2.7 (GND), U3.1 (PGND), U3.6 (AGND), U3.11 (PGND); also elsewhere on the board
unnamed: BZ1.2 (-), Q17.1 (C)
unnamed: C1.1, R6.2
unnamed: D3.1 (K), R8.2
unnamed: D4.1 (K), R11.2
unnamed: Q17.2 (B), R3.2, R4.2
unnamed: R12.1, U3.9 (EN)
unnamed: R7.2, U3.4 (FREQ)
unnamed: R13.1, U3.8 (PG)
unnamed: C11.2, L2.1, U3.12 (SW)
VBUS: C12.2, C13.1, C14.1, C15.2, R5.2, R12.2, U2.9 (Vin-), U3.2 (VIN), U3.10 (VIN); also elsewhere on the board
arm: J3.12; also elsewhere on the board
c1_fire: J3.5; also elsewhere on the board
c2_fire: J3.6; also elsewhere on the board
c3_fire: J3.7; also elsewhere on the board
c4_fire: J3.8; also elsewhere on the board
c5_fire: J3.9; also elsewhere on the board
c6_fire: J3.10; also elsewhere on the board
camera_enable: J3.11; also elsewhere on the board
cont_test: J3.14; also elsewhere on the board

Notes on the sheet:
power monitoring
input caps
supposed to be 1210
power indication
camera uart
green
3.3v regulation
yellow
5v regulation
can
output caps
buzzer
board to board connector
what the heck is this symbol digikey has failed me
feedback network
mounting holes double as power connectors

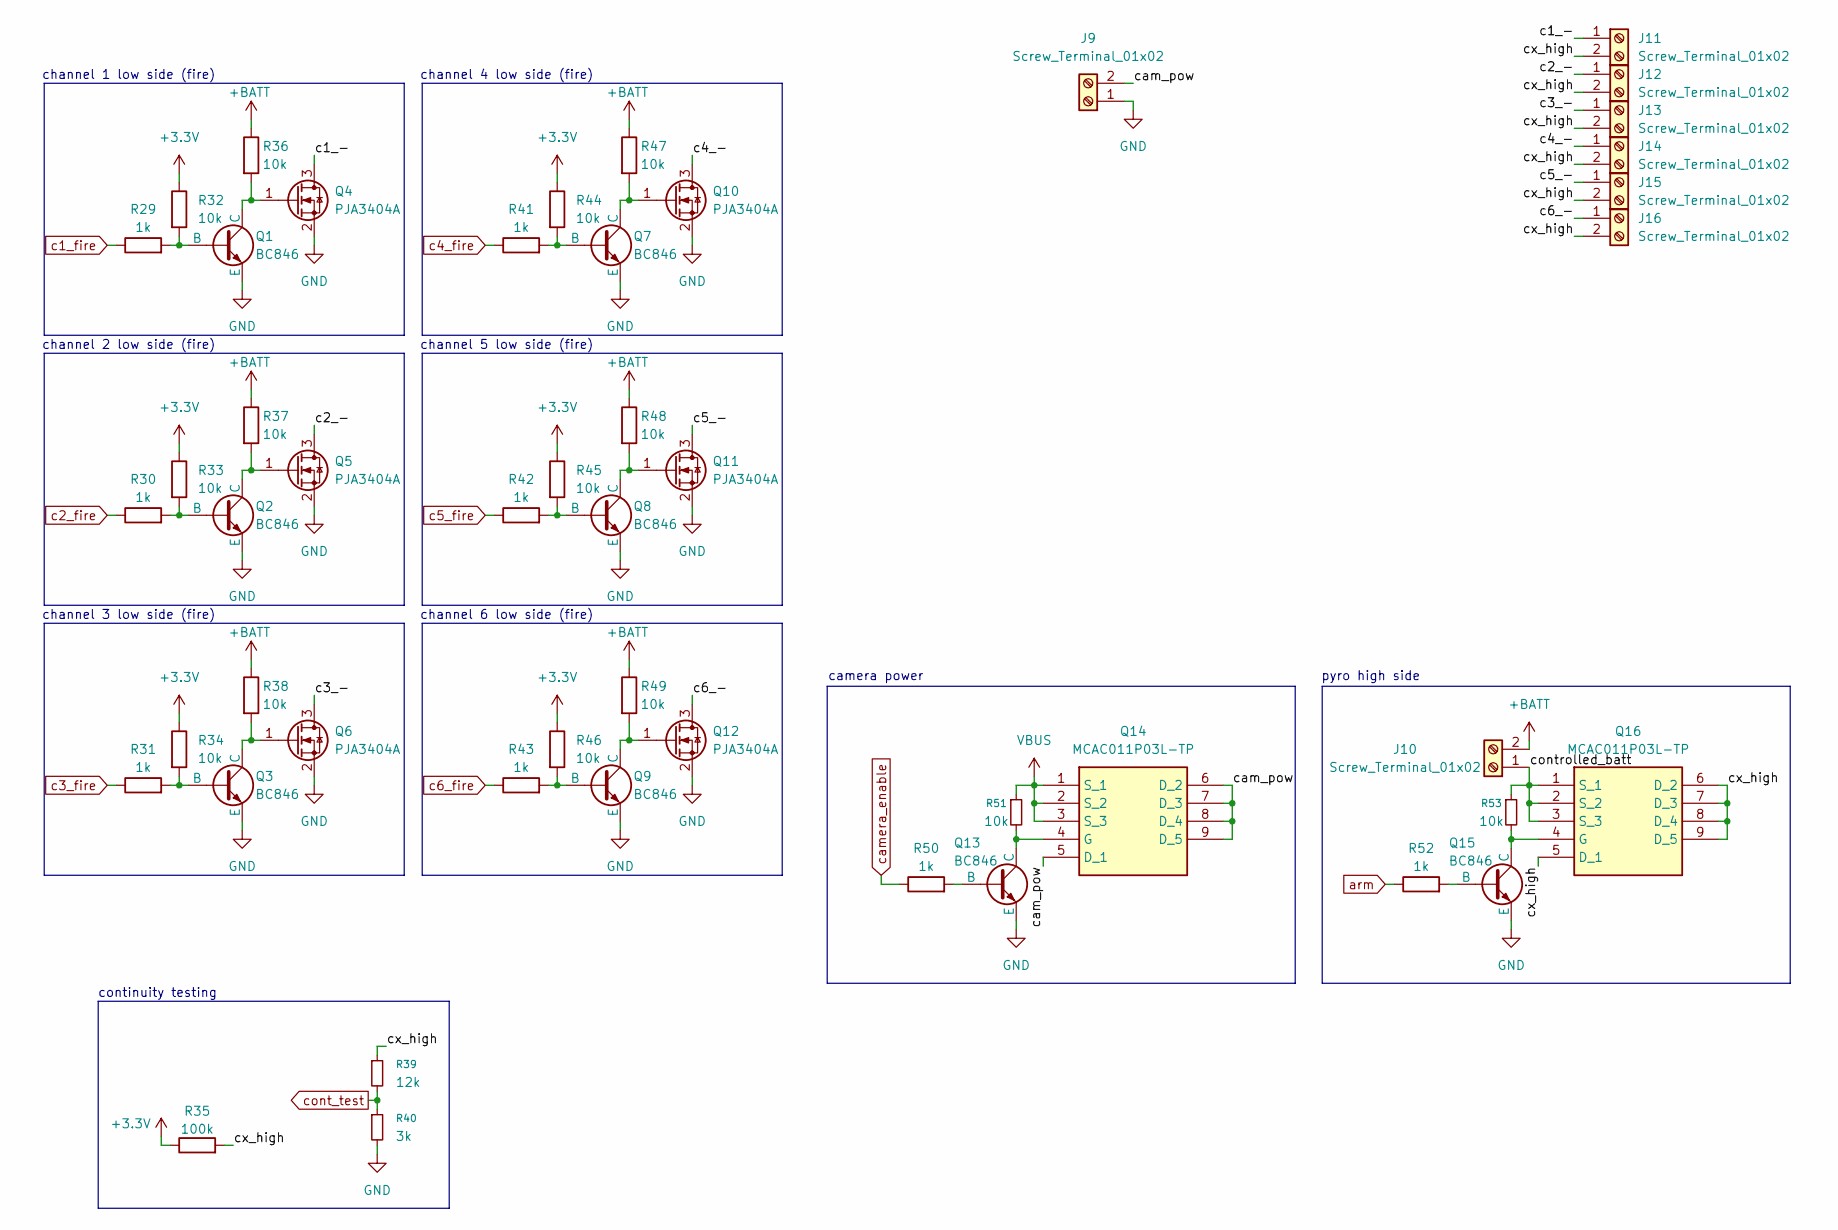
[picture p9: schematic power_control.kicad_sch]

Parts:
J9, J10, J11, J12, J13, J14, J15, J16: Screw_Terminal_01x02; kf350-2p
Q1, Q2, Q3, Q7, Q8, Q9, Q13, Q15: BC846; SOT-23-3
Q4, Q5, Q6, Q10, Q11, Q12: PJA3404A; SOT-23-3
Q14, Q16: MCAC011P03L-TP; MCAC100N08YATP; Manufacturer_Part_Number MCAC011P03L-TP
R29, R30, R31, R41, R42, R43, R50, R52: 1k; R_0402_1005Metric
R32, R33, R34, R36, R37, R38, R44, R45, R46, R47, R48, R49, R51, R53: 10k; R_0402_1005Metric
R35: 100k; R_0402_1005Metric
R39: 12k; R_0402_1005Metric
R40: 3k; R_0402_1005Metric

Connections:
+3.3V: R32.1, R33.1, R34.1, R35.1, R44.1, R45.1, R46.1; also elsewhere on the board
+BATT: J10.2, R36.1, R37.1, R38.1, R47.1, R48.1, R49.1; also elsewhere on the board
/power_control/c1_-: J11.1, Q4.3 (D)
/power_control/c2_-: J12.1, Q5.3 (D)
/power_control/c3_-: J13.1, Q6.3 (D)
/power_control/c4_-: J14.1, Q10.3 (D)
/power_control/c5_-: J15.1, Q11.3 (D)
/power_control/c6_-: J16.1, Q12.3 (D)
/power_control/cam_pow: J9.2, Q14.5 (D_1), Q14.6 (D_2), Q14.7 (D_3), Q14.8 (D_4), Q14.9 (D_5)
/power_control/controlled_batt: J10.1, Q16.1 (S_1), Q16.2 (S_2), Q16.3 (S_3), R53.1
/power_control/cx_high: J11.2, J12.2, J13.2, J14.2, J15.2, J16.2, Q16.5 (D_1), Q16.6 (D_2), Q16.7 (D_3), Q16.8 (D_4), Q16.9 (D_5), R35.2, R39.1
GND: J9.1, Q1.3 (E), Q2.3 (E), Q3.3 (E), Q4.2 (S), Q5.2 (S), Q6.2 (S), Q7.3 (E), Q8.3 (E), Q9.3 (E), Q10.2 (S), Q11.2 (S), Q12.2 (S), Q13.3 (E), Q15.3 (E), R40.2; also elsewhere on the board
unnamed: Q1.2 (B), R29.2, R32.2
unnamed: Q1.1 (C), Q4.1 (G), R36.2
unnamed: Q2.2 (B), R30.2, R33.2
unnamed: Q2.1 (C), Q5.1 (G), R37.2
unnamed: Q3.2 (B), R31.2, R34.2
unnamed: Q3.1 (C), Q6.1 (G), R38.2
unnamed: Q7.2 (B), R41.2, R44.2
unnamed: Q8.2 (B), R42.2, R45.2
unnamed: Q9.2 (B), R43.2, R46.2
unnamed: Q7.1 (C), Q10.1 (G), R47.2
unnamed: Q8.1 (C), Q11.1 (G), R48.2
unnamed: Q9.1 (C), Q12.1 (G), R49.2
unnamed: Q13.2 (B), R50.2
unnamed: Q13.1 (C), Q14.4 (G), R51.2
unnamed: Q15.2 (B), R52.2
unnamed: Q15.1 (C), Q16.4 (G), R53.2
VBUS: Q14.1 (S_1), Q14.2 (S_2), Q14.3 (S_3), R51.1; also elsewhere on the board
arm: R52.1; also elsewhere on the board
c1_fire: R29.1; also elsewhere on the board
c2_fire: R30.1; also elsewhere on the board
c3_fire: R31.1; also elsewhere on the board
c4_fire: R41.1; also elsewhere on the board
c5_fire: R42.1; also elsewhere on the board
c6_fire: R43.1; also elsewhere on the board
camera_enable: R50.1; also elsewhere on the board
cont_test: R39.2, R40.1; also elsewhere on the board

Notes on the sheet:
channel 6 low side (fire)
channel 2 low side (fire)
channel 1 low side (fire)
pyro high side
camera power
continuity testing
channel 4 low side (fire)
channel 5 low side (fire)
channel 3 low side (fire)

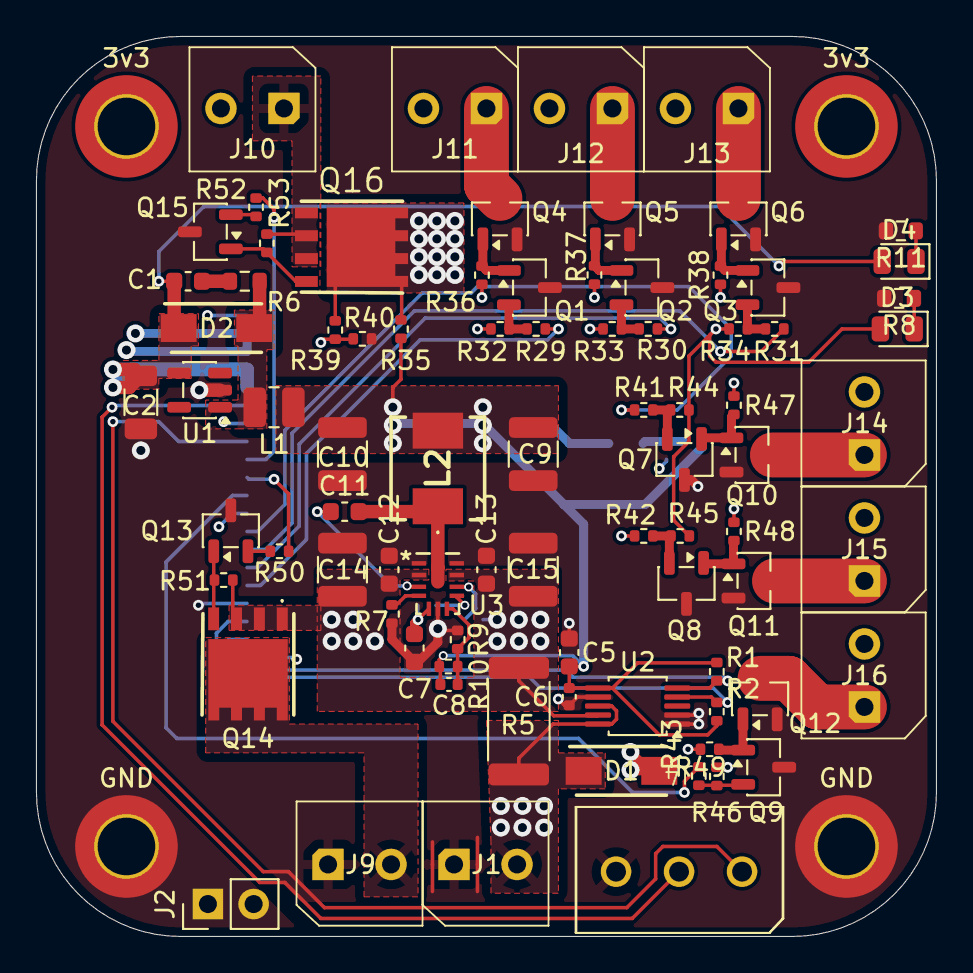
[picture p10: board IRISV2_BOTTOM.kicad_pcb from above]

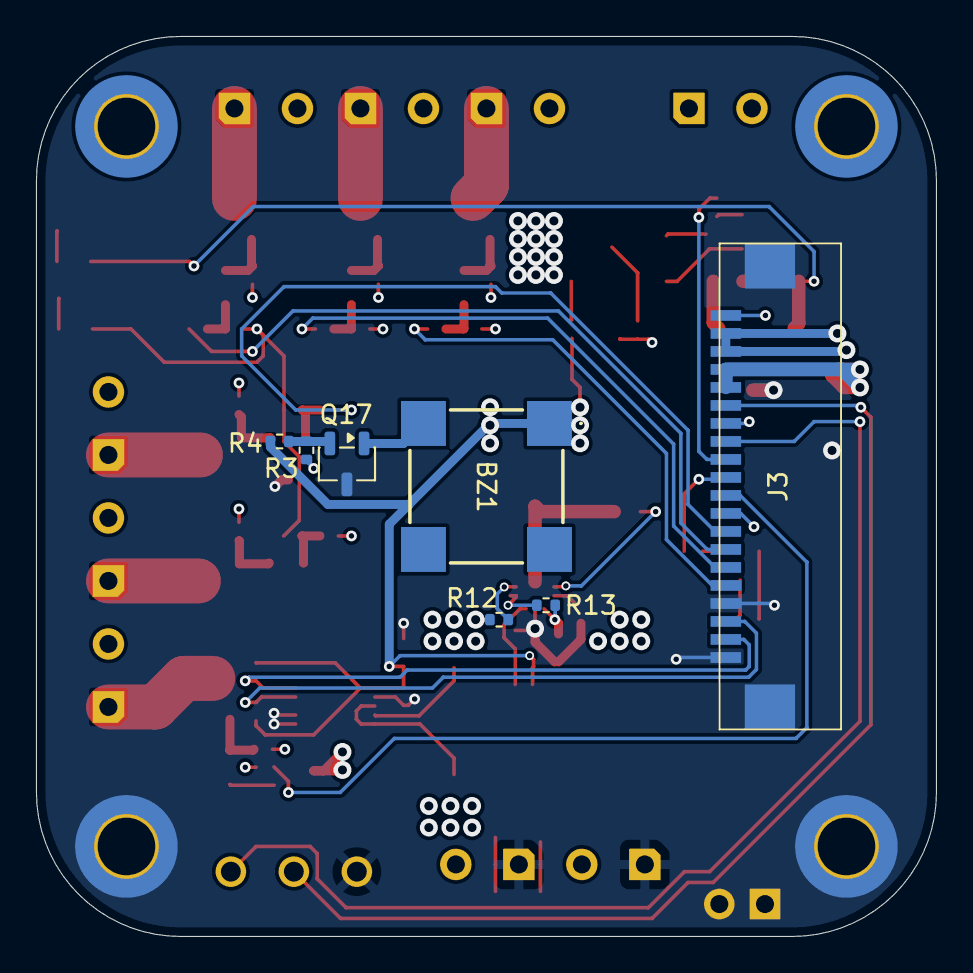
[picture p11: board IRISV2_BOTTOM.kicad_pcb from below]

Board: 4 copper layers, 50.0 x 50.0 mm, 94 parts (7 on the bottom side), 60 nets.

Other parts of the board:
3v3, 3v3#2: MountingHole_Pad; MountingHole_3.2mm_M3_ISO7380_Pad_TopBottom
GND: MountingHole_Pad; MountingHole_3.2mm_M3_ISO7380_Pad_TopBottom
GND#2: MountingHole_Pad; MountingHole_3.2mm_M3_ISO7380_Pad_TopBottom

Their connections:
+3.3V: 3v3.1, 3v3#2.1; also elsewhere on the board
GND: GND.1, GND#2.1; also elsewhere on the board
