teletype7/IRIS-v2/pcb/IRISV2_GPS/IRISV2_GPS.kicad_pcb

## KiCad design pcb/IRISV2_GPS/IRISV2_GPS.kicad_pcb (2026-07-19)

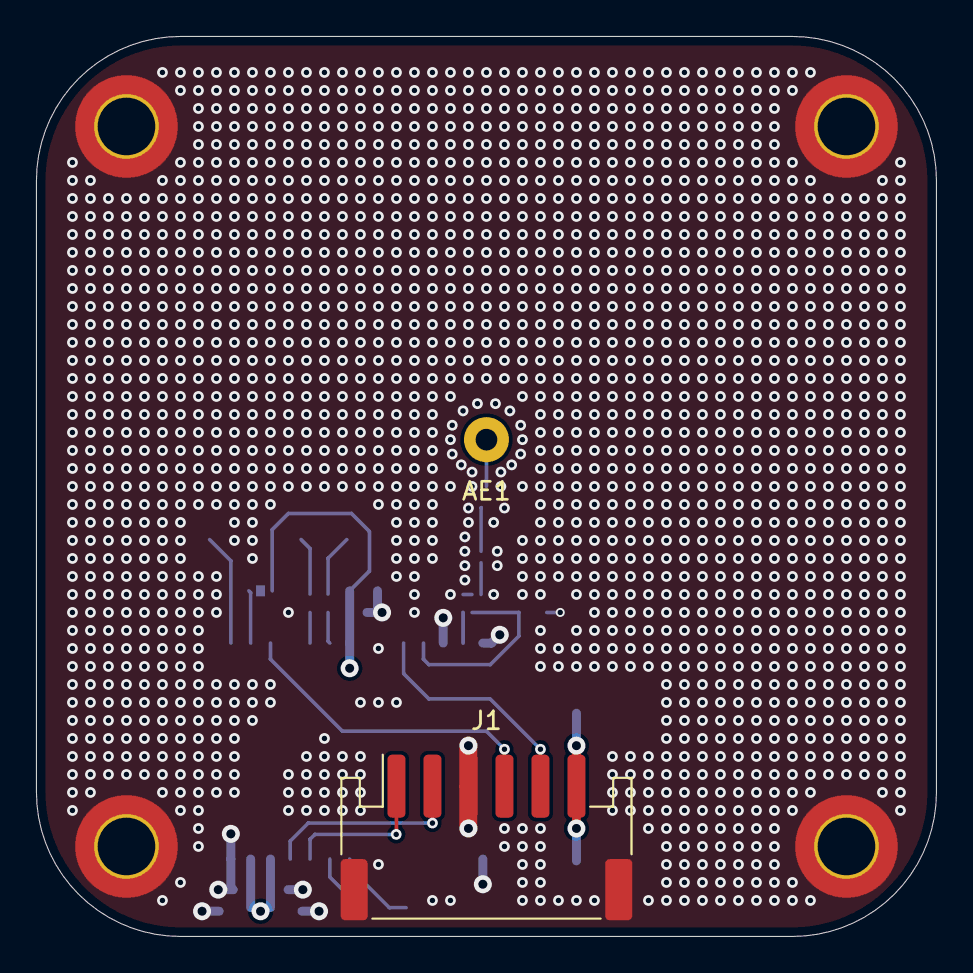
[picture p12: board IRISV2_GPS.kicad_pcb from above]

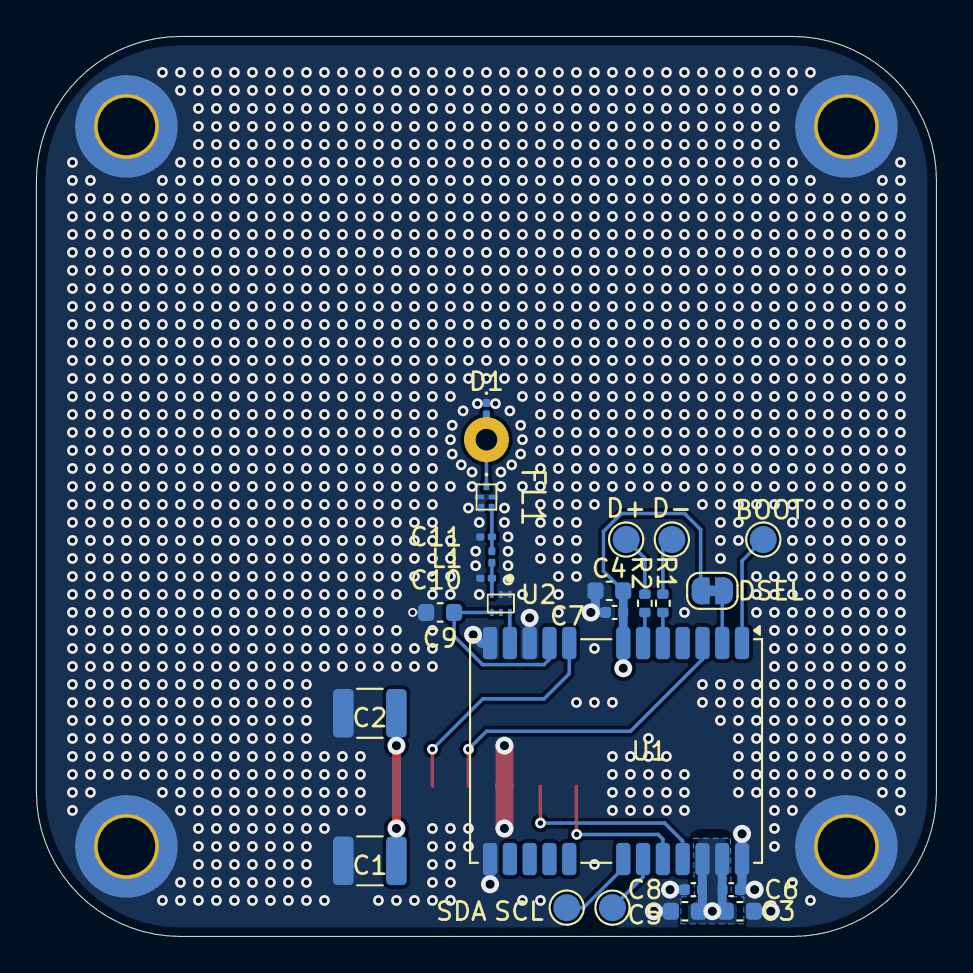
[picture p13: board IRISV2_GPS.kicad_pcb from below]

Board: 4 copper layers, 50.0 x 50.0 mm, 30 parts (24 on the bottom side), 19 nets.

Parts:
AE1: AANI-PP-0055
BOOT: GPS_BOOT; TestPoint_Pad_D1.5mm
C1, C2: 22uF; C_1210_3225Metric
C3, C4, C5, C9: 1uF; C_0603_1608Metric
C6, C7, C8: 100nF; C_0402_1005Metric
C10, C11: dnp; C_0201_0603Metric
D1: D_TVS; D_0201_0603Metric
D+: GPS_D+; TestPoint_Pad_D1.5mm
D-: GPS_D-; TestPoint_Pad_D1.5mm
DSEL: NC; SolderJumper-2_P1.3mm_Bridged_RoundedPad1.0x1.5mm
FL1: AFII-SW-0061-T; AFIISW0061T
H1, H2, H3, H4: MountingHole_Pad; MountingHole_3.2mm_M3_ISO7380_Pad_TopBottom
J1: Conn_01x06_MountingPin; JST_PH_S6B-PH-SM4-TB_1x06-1MP_P2.00mm_Horizontal
L1: 9.1nH; L_0201_0603Metric
R1, R2: 22; R_0402_1005Metric
SCL: GPS_SCL; TestPoint_Pad_D1.5mm
SDA: GPS_SDA; TestPoint_Pad_D1.5mm
U1: NEO-M9N; ublox_NEO
U2: lna; ALND-WB-0013-T

Connections:
+3.3V: C1.1, C2.1, C3.1, C4.1, C5.1, C6.1, C7.1, C8.1, DSEL.1 (A), J1.6, U1.7 (VDD_USB), U1.22 (V_BCKP), U1.23 (VCC)
GND: C1.2, C2.2, C3.2, C4.2, C5.2, C6.2, C7.2, C8.2, C9.2, C10.1, C11.2, D1.1 (A1), FL1.2 (GND), H1.1, H2.1, H3.1, H4.1, J1.3, J1.MP (MountPin), U1.10 (GND), U1.12 (GND), U1.13 (GND), U1.24 (GND), U2.1 (GND), U2.2 (GND)
unnamed: AE1.1 (A), D1.2 (A2), FL1.1 (INPUT)
unnamed: C11.1, FL1.4 (OUTPUT), L1.2
unnamed: DSEL.2 (B), U1.2 (D_SEL)
unnamed: D-.1, R1.1
unnamed: D+.1, R2.2
unnamed: U1.11 (RF_IN), U2.6 (RFOUT)
unnamed: SCL.1, U1.19 (SCL/SPI_CLK)
unnamed: SDA.1, U1.18 (SDA/~SPI_CS)
unnamed: R1.2, U1.5 (USB_DM)
unnamed: R2.1, U1.6 (USB_DP)
unnamed: C9.1, U1.9 (VCC_RF), U2.4 (VDD), U2.5 (Ven)
unnamed: BOOT.1, U1.1 (~SAFEBOOT)
unnamed: C10.2, L1.1, U2.3 (RFIN)
gps_mrx: J1.1, U1.20 (TXD/SPI_MISO)
gps_mtx: J1.2, U1.21 (RXD/SPI_MOSI)
gps_pps: J1.4, U1.3 (TIMEPULSE)
gps_rst: J1.5, U1.8 (~RESET)
