teletype7/IRIS-v2/firmware/main_mcu/main_mcu.ioc

Mcu.UserName=STM32H563VITx
PA0.Signal=S_TIM2_CH1
PA1.Signal=S_TIM2_CH2
PA10.Signal=USART1_RX
PA11.Signal=USB_DM
PA12.Signal=USB_DP
PA13(JTMS/SWDIO).Signal=DEBUG_JTMS-SWDIO
PA14(JTCK/SWCLK).Signal=DEBUG_JTCK-SWCLK
PA15(JTDI).Signal=SPI3_NSS
PA2.Signal=S_TIM2_CH3
PA3.Signal=S_TIM2_CH4
PA4.Signal=SPI1_NSS
PA5.Signal=SPI1_SCK
PA6.Signal=SPI1_MISO
PA7.Signal=SPI1_MOSI
PA9.Signal=USART1_TX
PB12.Signal=SPI2_NSS
PB13.Signal=SPI2_SCK
PB14.Signal=SPI2_MISO
PB15.Signal=SPI2_MOSI
PB3(JTDO/TRACESWO).Signal=SPI6_SCK
PB4(NJTRST).Signal=SPI6_MISO
PB5.Signal=SPI6_MOSI
PB7.Signal=I2C1_SDA
PB8.Signal=I2C1_SCL
PC10.Signal=SPI3_SCK
PC11.Signal=SPI3_MISO
PC12.Signal=SPI3_MOSI
PC14-OSC32_IN(OSC32_IN).Signal=RCC_OSC32_IN
PC15-OSC32_OUT(OSC32_OUT).Signal=RCC_OSC32_OUT
PC4.Signal=GPXTI4
PC6.Signal=S_TIM3_CH1
PC7.Signal=S_TIM3_CH2
PC8.Signal=S_TIM3_CH3
PC9.Signal=S_TIM3_CH4
PD0.Signal=FDCAN1_RX
PD1.Signal=FDCAN1_TX
PD10.Signal=GPXTI10
PD11.Signal=UART4_RX
PD12.Signal=UART4_TX
PD2.Signal=GPXTI2
PD3.Signal=GPIO_Output
PD5.Signal=USART2_TX
PD6.Signal=USART2_RX
PD8.Signal=USART3_TX
PD9.Signal=USART3_RX
PE0.Signal=GPIO_Output
PE14.Signal=S_TIM1_CH4
PE2.Signal=SPI4_SCK
PE3.Signal=GPXTI3
PE4.Signal=SPI4_NSS
PE5.Signal=SPI4_MISO
PE6.Signal=SPI4_MOSI
PH0-OSC_IN(PH0).Signal=RCC_OSC_IN
PH1-OSC_OUT(PH1).Signal=RCC_OSC_OUT
