teletype7/IRIS-v2/(commit log)

2026-04-11 initial - schematic work done, main mcu pinout started
    [irisv2.kicad_pcb, irisv2.kicad_sch, main_mcu.kicad_sch, peripheral_mcu.kicad_sch, rf.kicad_sch, sensors.kicad_sch]
2026-04-11 fixed super minor issues
    [irisv2.kicad_sch]
2026-04-13 tons of work on rf and mcu
    [irisv2.kicad_sch, main_mcu.kicad_sch, peripheral_mcu.kicad_sch, rf.kicad_sch]
2026-04-16 added missing files, rf stuff done I think (hope)
    [main_mcu.kicad_sch, peripheral_mcu.kicad_sch, rf.kicad_sch]
2026-04-20 sensors pretty much done (still need to add high g_
    [irisv2.kicad_sch, main_mcu.kicad_sch, rf.kicad_sch, sensors.kicad_sch]
2026-04-21 got fets figured out (finally), can integrated, a 5v regulator, sensors added - overall great progress!
    [fets.kicad_sch, irisv2.kicad_sch, main_mcu.kicad_sch, peripheral_mcu.kicad_sch, rf.kicad_sch, sensors.kicad_sch]
2026-05-10 pretty much everything on schem done, though need to add circuit protection stuff and break out remaining pins
    [fets.kicad_sch, irisv2.kicad_sch, main_mcu.kicad_sch, peripheral_mcu.kicad_sch, rf.kicad_sch, sensors.kicad_sch]
2026-05-11 yay schematic pretty much good, though I'm going to have to redo some work to split it into multiple kicad projects so I can have multiple separate boards
    [fets.kicad_sch, irisv2.kicad_pcb, irisv2.kicad_sch, main_mcu.kicad_sch, peripheral_mcu.kicad_sch, rf.kicad_sch, sensors.kicad_sch]
2026-05-12 split into subprojects, fixed up stuff, started real pcb work
    [IRISV2_BOTTOM.kicad_pcb, IRISV2_BOTTOM.kicad_sch, IRISV2_GPS.kicad_pcb, IRISV2_GPS.kicad_sch, IRISV2_TOP.kicad_pcb, IRISV2_TOP.kicad_sch, irisv2.kicad_pcb, irisv2.kicad_sch]
2026-05-24 bottom pcb now mostly done, connectors selected - now need to finish integrating the connectors and other small tweaks to bottom routing
    [IRISV2_BOTTOM.kicad_pcb, IRISV2_BOTTOM.kicad_sch, power_control.kicad_sch]
2026-05-24 bottom board design done, need to polish it
    [IRISV2_BOTTOM.kicad_pcb, IRISV2_BOTTOM.kicad_sch]
2026-05-24 bottom board pending sanity check but done
    [IRISV2_BOTTOM.kicad_pcb]
2026-05-25 gps finished minus tvs (WHY ARE THEY ALL 0201), top layout + routing started
    [IRISV2_GPS.kicad_pcb, IRISV2_GPS.kicad_sch, IRISV2_TOP.kicad_pcb, IRISV2_TOP.kicad_sch, lr2021.kicad_sch, main_mcu.kicad_sch, peripheral_mcu.kicad_sch, sensors.kicad_sch]
2026-05-26 removed high g accel, top board layout looking decent, routing started also - though i realized i was missing the micro sd card and that's going to be a pain to add
    [IRISV2_GPS.kicad_pcb, IRISV2_GPS.kicad_sch, IRISV2_TOP.kicad_pcb, IRISV2_TOP.kicad_sch, lr2021.kicad_sch, main_mcu.kicad_sch, peripheral_mcu.kicad_sch, sensors.kicad_sch]
2026-05-26 layout pretty much done, lr2021 rf stuff done, mostly just routing left
    [IRISV2_TOP.kicad_pcb, lr2021.kicad_sch, peripheral_mcu.kicad_sch]
2026-07-06 about to redo lr routing
    [IRISV2_BOTTOM.kicad_pcb]
2026-07-06 lr2021 reroute, maybe need to do stuff with gps lna bc iip3 and ip1db
    [IRISV2_GPS.kicad_sch, IRISV2_TOP.kicad_pcb, lr2021.kicad_sch]
2026-07-08 most routing done inc some reassignment, pretty much just connectors left now
    [IRISV2_TOP.kicad_pcb, main_mcu.kicad_sch, peripheral_mcu.kicad_sch]
2026-07-10 all main routing done, need to break out remaining gpio onto banks of mpu and ppu
    [IRISV2_BOTTOM.kicad_pcb, IRISV2_BOTTOM.kicad_sch, IRISV2_TOP.kicad_pcb, IRISV2_TOP.kicad_sch, main_mcu.kicad_sch, peripheral_mcu.kicad_sch]
2026-07-17 fixed some issues, lr2021 matching is now 0201 - todo change trace width to match pad width like ref design, see todo for rest
    [IRISV2_BOTTOM.kicad_pcb, IRISV2_BOTTOM.kicad_sch, IRISV2_GPS.kicad_pcb, IRISV2_GPS.kicad_sch, IRISV2_TOP.kicad_pcb, lr2021.kicad_sch]
2026-07-19 removed usb, added connectors and stuff, 3d models mostly added, still need to route out gpio and servos (though connectors added)
    [IRISV2_BOTTOM.kicad_pcb, IRISV2_BOTTOM.kicad_sch, IRISV2_GPS.kicad_pcb, IRISV2_TOP.kicad_pcb, IRISV2_TOP.kicad_sch, main_mcu.kicad_sch, peripheral_mcu.kicad_sch]
2026-07-19 3d models nearly done, just missing a few, gpio header routed - about to change lr2021 trace width
    [IRISV2_BOTTOM.kicad_pcb, IRISV2_GPS.kicad_pcb, IRISV2_TOP.kicad_pcb, main_mcu.kicad_sch, peripheral_mcu.kicad_sch]
2026-07-19 lr2021 trace width changed, with teardrops
    [IRISV2_TOP.kicad_pcb]
2026-07-20 pcb hopefully mostly finalized
    [IRISV2_BOTTOM.kicad_pcb, IRISV2_BOTTOM.kicad_sch, IRISV2_TOP.kicad_pcb, IRISV2_TOP.kicad_sch, main_mcu.kicad_sch]
